Alex-Pennington/ArduinoHydraulicScale/README.md

Parts List and instructions can be found at
https://www.organicengineer.com/projects
