Alex-Pennington/ArduinoHydraulicScale/docs/superpowers/plans/2026-09-13-4-20ma-loop.md

# PLC #4 — 4-20 mA current loop implementation plan

> **For agentic workers:** REQUIRED SUB-SKILL: Use superpowers:subagent-driven-development (recommended) or superpowers:executing-plans to implement this plan task-by-task. Steps use checkbox (`- [ ]`) syntax for tracking.

**Goal:** Replace PLC #4's 0.5-4.5 V ratiometric pressure front end with a 4-20 mA current loop, and in doing so retire the two diagnostic defects the voltage front end cannot express.

**Verification available here:** `./tools/build-check.sh` compiles the firmware for `arduino:renesas_uno:unor4wifi` using Saga's `arduino-cli`, and `test/test_loop_scaling.cpp` runs the scaling arithmetic on the host with `g++`. Both were run on 2026-09-13 before this plan was handed over. **No board is tethered and nothing is flashed.**

**Architecture:** Milliamps become the source of truth. A new header `include/loop_scaling.h` holds the burden resistor, the NAMUR thresholds in mA, a `constexpr` that derives ADC counts from them, a five-state classifier, and the psi conversion — all free of Arduino dependencies so it can be compiled and checked on the host. `src/ArduinoHydraulicScale.cpp` includes it and loses its four hard-coded count constants and its three-state enum.

**Tech Stack:** C++17, Arduino framework, UNO R4 WiFi. Built with Saga's `arduino-cli` (`arduino:renesas_uno:unor4wifi`) via `tools/build-check.sh` — **not** PlatformIO, despite the tracked `platformio.ini`. Host checks build with `g++`.

**Spec:** `MA-LOOP-DESIGN.md`. Decisions, their owners and the hardware reasoning are in `notes/2026-09-13-4-20ma-loop-decisions.md`. **Read both — this plan argues from them and does not repeat their reasoning.**

---

## Global Constraints

- **Base branch is `plc4/mqtt-port`, not `main`.** HEAD is thirty commits ahead of `main`, which is stale upstream refactor history. Never diff against or merge from `main`.
- **Work on `feat/plc4-4-20ma-loop`.** Never push to `origin` — `CLAUDE.md` forbids it. Commit locally.
- **Never `git add -A` or `git commit -a`.** Stage by explicit path. Other sessions share this repo.
- **Alex is the tester.** Do not write, invent or critique a commissioning test, a bench procedure, or anything performed at the machine. The host checks in Task 1 prove arithmetic, not hardware.
- **Do not flash. Do not operate the tractor.** `tools/build-check.sh` compiles and never opens a port; keep it that way.
- **Toolchain is `arduino-cli` on Saga**, not PlatformIO. Do not install PlatformIO.
- **Burden resistor is 150 ohm.** `BURDEN_OHMS` is the only constant describing hardware; every threshold derives from it. Never hand-write a count.
- **`sensorMaxPSI` default is 3000** — a Rosemount 1151, 0-3000 psi.
- **NE43 fault-high is 21.0 mA, never 20.5.** `MA-LOOP-DESIGN.md` §2 carries the full argument; 20.5 would report a legitimately saturated transmitter as failed, which is the exact defect being fixed.
- **A0 is untouched.** The keypad ladder and the `analogReadResolution` flips — four calls, plus the one comment that names them — stay exactly as they are.
- **Describe problems, do not fix them, outside this feature.** Anything else you find goes in `findings/` or to the coordinator, not into a commit.
- **Verify every line number yourself before editing.** The numbers in this plan were verified on 2026-09-13 against `7e7f2f4`; earlier tasks in this plan will move them.

---

## The predicate split — read this before writing any code

This is the single most likely place to introduce a bug, because the old code had one predicate and the new code needs two.

The old enum had one "good" state, so `sensorState != SENSOR_OK` meant both *"don't trust this reading"* and *"don't let the operator act"*. The new enum splits those:

```cpp
loopState != LOOP_OK        // REFUSE AN OPERATOR ACTION  (tare, +, kv)
loopIsMeasuring(loopState)  // TRUST THE READING          (LCD, psi, filter)
```

They differ on exactly two states:

| state | `!= LOOP_OK` | `loopIsMeasuring()` | so… |
|---|---|---|---|
| `LOOP_UNDER` | refuses | **true** | reading is kept and published; operator cannot tare or calibrate on it |
| `LOOP_SATURATED` | refuses | **true** | weight stays on the LCD, psi is published, but no new tare or calibration |

**Do not "simplify" these back into one predicate.** Collapsing them toward `!= LOOP_OK` throws away the saturated readings this feature exists to capture. Collapsing them toward `loopIsMeasuring()` lets an operator calibrate against a pinned transmitter.

---

## File structure

| File | Status | Responsibility |
|---|---|---|
| `include/loop_scaling.h` | **create** | Burden, vref, mA thresholds, count derivation, `LoopState`, classifier, mA and psi conversion. No Arduino dependency. |
| `test/test_loop_scaling.cpp` | **create** | Host-side check of the above. Built with `g++` on the host, not cross-compiled. |
| `src/ArduinoHydraulicScale.cpp` | modify | Consumes the header; loses its four count constants and three-state enum. |
| `OPERATOR.md` | modify | New LCD strings; the forced recalibration after flashing. |
| `BRIEF.md` | modify | Hardware picture: transmitter, burden, loop supply. |
| `tools/build-check.sh` | **exists** | Assembles a scratch sketch and compiles it with `arduino-cli`. Never flashes. |

---

## Task 0: Confirm the compile check works — PREREQUISITE, and it is quick

**This repo CAN be compiled, and this plan's earlier draft was wrong to say otherwise.**
`CLAUDE.md` says nothing here has been compiled or flashed. That is stale: Saga carries
`arduino-cli` 1.5.0 with `arduino:renesas_uno` 1.6.0, and Alex confirms the estate has been
flashing with it. PlatformIO is **not** installed and is not needed — do not install it.

The repo is PlatformIO-layout (`src/*.cpp`) but `arduino-cli` wants a sketch *directory*
containing `<name>.ino`. `tools/build-check.sh` bridges that by assembling a throwaway sketch in
a scratch directory. **It never flashes and takes no port argument.** Flashing is Alex's, at the
machine.

**Files:** none modified.

- [ ] **Step 1: Compile the untouched baseline**

```bash
./tools/build-check.sh
```

Expected, verified on 2026-09-13 at `7e7f2f4`:

```
Sketch uses 85008 bytes (32%) of program storage space. Maximum is 262144 bytes.
Global variables use 11196 bytes (34%) of dynamic memory, leaving 21572 bytes for local variables.
```

**Write those two numbers down.** Every later task compares against them.

- [ ] **Step 2: Know which warning is not yours**

```
WARNING: library WDT claims to run on renesas architecture(s) and may be
incompatible with your current board which runs on renesas_uno architecture(s).
```

**Pre-existing.** It appears on the untouched baseline. Do not chase it and do not "fix" it — it
is outside this feature, and the standing constraint is to describe problems found outside the
feature, not fix them.

- [ ] **Step 3: If it fails, stop and report**

If `arduino-cli` is missing or the core is gone, **say so plainly and mark this task FAILED**.
Do not install a second toolchain, do not fall back to PlatformIO, and above all **never report a
build you did not run.** Every later task's verification step depends on this one working.

**Nothing to commit.**

---

## Task 1: `include/loop_scaling.h` and its host check

The only task in this plan with verification that does not depend on Task 0. It is also where the highest-risk content lives: `src/ArduinoHydraulicScale.cpp` already carries **three** documented instances of a hand-derived scaling constant left stale when the resolution changed (`:914-919` names all three). This header exists so there is no hand-derived constant to go stale, and this test exists to prove the derivation.

**Files:**
- Create: `include/loop_scaling.h`
- Create: `test/test_loop_scaling.cpp`

**Interfaces — later tasks rely on exactly these names:**

```cpp
enum LoopState { LOOP_OK, LOOP_DEAD, LOOP_UNDER, LOOP_SATURATED, LOOP_FAULT_HIGH };

constexpr int   mAToCounts(float mA);
constexpr int   COUNTS_DEAD, COUNTS_ZERO, COUNTS_FS, COUNTS_FAULT_HIGH;
LoopState       classifyLoop(int counts);
bool            loopIsMeasuring(LoopState s);
const char     *loopStateName(LoopState s);
float           countsToMilliamps(int counts);
int             countsToPSI(int counts, int maxPSI);
```

- [ ] **Step 1: Write the failing test**

Create `test/test_loop_scaling.cpp`:

```cpp
// Host-side check of the 4-20 mA scaling arithmetic in include/loop_scaling.h.
//
// Built with g++ ON THE HOST. The firmware itself cross-compiles fine via
// tools/build-check.sh, but a compile proves only that the arithmetic is legal,
// not that it is right. This file carries no Arduino dependency so the values
// can actually be RUN and inspected, which on a board nobody has tethered is
// otherwise impossible.
//
//   g++ -std=c++17 -Wall -Wextra -Iinclude test/test_loop_scaling.cpp -o /tmp/t
//   /tmp/t
//
// (No backslash continuation in that comment -- a trailing backslash on a //
// line trips -Wcomment, and this file must build warning-free.)
//
// THIS IS NOT A COMMISSIONING TEST. It proves arithmetic. It proves nothing
// about a transmitter, a burden resistor, or a tractor. Alex writes those.

#include "loop_scaling.h"
#include <cstdio>

static int failures = 0;

static void check_int(const char *what, long got, long want) {
  if (got == want) { printf("  ok    %-44s %ld\n", what, got); }
  else { printf("  FAIL  %-44s got %ld want %ld\n", what, got, want); failures++; }
}

static void check_near(const char *what, double got, double want, double tol) {
  double d = got - want; if (d < 0) d = -d;
  if (d <= tol) { printf("  ok    %-44s %.4f\n", what, got); }
  else { printf("  FAIL  %-44s got %.4f want %.4f\n", what, got, want); failures++; }
}

static void check_state(const char *what, LoopState got, LoopState want) {
  if (got == want) { printf("  ok    %-44s %s\n", what, loopStateName(got)); }
  else { printf("  FAIL  %-44s got %s want %s\n", what,
                loopStateName(got), loopStateName(want)); failures++; }
}

// The derived counts, against the values in MA-LOOP-DESIGN.md §2. If the burden
// is ever changed these must be recomputed there and here together.
static_assert(COUNTS_DEAD       == 1720,  "3.5 mA against 150 ohm");
static_assert(COUNTS_ZERO       == 1966,  "4.0 mA against 150 ohm");
static_assert(COUNTS_FS         == 9830,  "20.0 mA against 150 ohm");
static_assert(COUNTS_FAULT_HIGH == 10321, "21.0 mA against 150 ohm");

int main() {
  printf("counts derived from BURDEN_OHMS\n");
  check_int("3.5 mA  live-zero floor", COUNTS_DEAD,        1720);
  check_int("4.0 mA  live zero",       COUNTS_ZERO,        1966);
  check_int("20.0 mA full scale",      COUNTS_FS,          9830);
  check_int("21.0 mA NE43 fault-high", COUNTS_FAULT_HIGH, 10321);
  check_int("25.0 mA stays on scale",  mAToCounts(25.0f) <= 16383, 1);

  printf("\nclassifier boundaries -- every band edge, both sides\n");
  // AN OPEN LOOP READS ZERO, AND THAT IS THE WHOLE POINT OF THE SWAP.
  // The old front end's open-circuit defect was a floating CMOS input sitting
  // near mid-rail at ~4401 counts and reporting ok. There is deliberately NO
  // test for 4401 here: with a 150 ohm burden across the input a broken loop
  // CANNOT produce it -- 0 mA develops 0 V. The hardware closed that path, not
  // the classifier, and a test asserting otherwise would misrepresent the fix.
  check_state("0 counts -- open loop",        classifyLoop(0),     LOOP_DEAD);
  check_state("1719 -- just under 3.5 mA",    classifyLoop(1719),  LOOP_DEAD);
  check_state("1720 -- exactly 3.5 mA",       classifyLoop(1720),  LOOP_UNDER);
  check_state("1965 -- just under live zero", classifyLoop(1965),  LOOP_UNDER);
  check_state("1966 -- exactly live zero",    classifyLoop(1966),  LOOP_OK);
  check_state("9829 -- just under full scale",classifyLoop(9829),  LOOP_OK);
  check_state("9830 -- exactly full scale",   classifyLoop(9830),  LOOP_SATURATED);
  check_state("10320 -- just under NE43",     classifyLoop(10320), LOOP_SATURATED);
  check_state("10321 -- exactly NE43 21 mA",  classifyLoop(10321), LOOP_FAULT_HIGH);
  check_state("16383 -- ADC rail",            classifyLoop(16383), LOOP_FAULT_HIGH);

  printf("\nwhich states are still measuring\n");
  // SATURATED IS MEASURING. NE43 puts 20.0-20.5 mA in the valid measuring range
  // and this is the defect the swap exists to fix: today a real pressure
  // excursion publishes as a wiring fault. If this line ever flips to false,
  // the fix has been undone.
  check_int("LOOP_OK measures",         loopIsMeasuring(LOOP_OK),         1);
  check_int("LOOP_UNDER measures",      loopIsMeasuring(LOOP_UNDER),      1);
  check_int("LOOP_SATURATED MEASURES",  loopIsMeasuring(LOOP_SATURATED),  1);
  check_int("LOOP_DEAD does not",       loopIsMeasuring(LOOP_DEAD),       0);
  check_int("LOOP_FAULT_HIGH does not", loopIsMeasuring(LOOP_FAULT_HIGH), 0);

  printf("\ncounts back to milliamps\n");
  check_near("live zero is 4 mA",  countsToMilliamps(COUNTS_ZERO),  4.0,  0.01);
  check_near("full scale is 20 mA",countsToMilliamps(COUNTS_FS),   20.0,  0.01);
  check_near("zero counts is 0 mA",countsToMilliamps(0),            0.0,  0.01);

  printf("\ncounts to psi, span 3000\n");
  check_int("live zero is 0 psi",      countsToPSI(COUNTS_ZERO, 3000),    0);
  check_int("full scale is 3000 psi",  countsToPSI(COUNTS_FS,   3000), 3000);
  check_int("midspan is 1500 psi",     countsToPSI(5898,        3000), 1500);
  // The floor. map() does not clamp, and LOOP_UNDER sits below the live zero,
  // so without this a healthy-looking negative pressure reaches the wire.
  check_int("below live zero floors at 0", countsToPSI(COUNTS_DEAD, 3000), 0);
  check_int("zero counts floors at 0",     countsToPSI(0,           3000), 0);
  // Above full scale it EXTRAPOLATES, deliberately: a saturating transmitter is
  // proportional up to its clamp. Per playbook §10 this is a validity boundary,
  // not a scale marking -- read it as "at least this much".
  check_int("saturated extrapolates",  countsToPSI(10000, 3000), 3064);

  printf("\n%s\n", failures ? "FAILURES" : "all checks passed");
  return failures ? 1 : 0;
}
```

- [ ] **Step 2: Run it and confirm it fails**

```bash
g++ -std=c++17 -Wall -Wextra -Iinclude -o /tmp/test_loop_scaling \
    test/test_loop_scaling.cpp && /tmp/test_loop_scaling
```

Expected: FAIL — `fatal error: loop_scaling.h: No such file or directory`.

- [ ] **Step 3: Write the header**

Create `include/loop_scaling.h`:

```cpp
#pragma once

// ---------------------------------------------------------------------------
// PLC #4 — 4-20 mA current loop front end.
//
// The transmitter is a Rosemount 1151, 0-3000 psi, 2-wire, fed from a DEDICATED
// 24 V supply whose negative is bonded to this board's GND. Loop current is read
// as the voltage across a burden resistor from A2 to GND.
//
// BURDEN_OHMS IS THE ONLY NUMBER HERE THAT DESCRIBES HARDWARE. Change it and
// every threshold below follows. NEVER HAND-WRITE A COUNT: this firmware already
// carries three cases of a hand-derived scaling constant left stale when the
// resolution changed, and a count that silently *means* 21.0 mA would be a
// fourth.
//
// WHY 150 OHM, so nobody re-argues it on resolution grounds: resolution binds on
// nothing -- every candidate from 100 to 250 ohm is 52-131x finer than the
// sensor's own +/-1.0% FS -- and compliance binds on nothing at 24 V. What binds
// is that PLC #3 metered a 29.7 mA hard-over; against 200 ohm that puts 5.94 V
// on this pin, 0.94 V above AVCC and into the ESD clamp. 150 ohm holds to
// 33.3 mA. Full trade table: notes/2026-09-13-4-20ma-loop-decisions.md §2.
//
// BURDEN TOLERANCE IS NOW A CALIBRATION TERM AND IT WAS NOT BEFORE. A 1% burden
// is +/-30 psi at 3000 -- the entire sensor accuracy budget. Specify 0.1%,
// <=25 ppm/degC; at 100 ppm/degC a 60 degC enclosure swing adds another 18 psi.
//
// AND SO IS AVCC. The old transducer was RATIOMETRIC: its output tracked AVCC,
// so AVCC error cancelled. A burden does not cancel -- the reading is I*R/AVCC,
// so ADC_VREF_V below is a direct gain term. 5.0 is an ASSUMPTION about a rail
// that on USB power is typically 4.75-5.25 V. UNRESOLVED; may want measuring.
//
// Deliberately free of Arduino headers so test/test_loop_scaling.cpp can check
// the arithmetic on the host, where nothing else in this firmware can be run.
// ---------------------------------------------------------------------------

constexpr float BURDEN_OHMS = 150.0f;   // 0.1%, <=25 ppm/degC, A2 to GND
constexpr float ADC_VREF_V  = 5.0f;     // see the AVCC warning above
constexpr int   ADC_FS      = 16383;    // 14-bit full scale is 16383, not 16384

constexpr int mAToCounts(float mA) {
  return (int)(mA * BURDEN_OHMS / ADC_VREF_V / 1000.0f * (float)ADC_FS + 0.5f);
}

// NAMUR NE43 and the estate's settled figures. Every value cites a source; none
// is invented here.
//
// WHY 21.0 AND NOT 20.5, because it will be questioned. NE43 puts the valid
// measuring range at 3.8-20.5 mA and the fault signal at >=21.0; 20.5-21.0 is
// over-range-but-still-measuring and is deliberately NOT a fault. 21.0 also sits
// in the gap for both Rosemount alarm configurations (standard saturates 20.8 /
// alarms >=21.75; NE43 option saturates 20.5 / alarms >=21.5), so it
// discriminates correctly without anyone knowing the option code.
//
// A 20.5 THRESHOLD WOULD BE WRONG RATHER THAN CONSERVATIVE: it would report a
// transmitter legitimately pinned at full scale, measuring correctly and saying
// so, as FAILED -- which is precisely the defect this front end exists to fix.
constexpr float LOOP_DEAD_MA       =  3.5f;  // playbook §5; PLC #1 CURRENT_DEAD_LOOP_MA
constexpr float LOOP_ZERO_MA       =  4.0f;  // live zero
constexpr float LOOP_FS_MA         = 20.0f;  // span end
constexpr float LOOP_FAULT_HIGH_MA = 21.0f;  // NAMUR NE43

constexpr int COUNTS_DEAD       = mAToCounts(LOOP_DEAD_MA);        // 1720
constexpr int COUNTS_ZERO       = mAToCounts(LOOP_ZERO_MA);        // 1966
constexpr int COUNTS_FS         = mAToCounts(LOOP_FS_MA);          // 9830
constexpr int COUNTS_FAULT_HIGH = mAToCounts(LOOP_FAULT_HIGH_MA);  // 10321

enum LoopState { LOOP_OK, LOOP_DEAD, LOOP_UNDER, LOOP_SATURATED, LOOP_FAULT_HIGH };

inline LoopState classifyLoop(int counts) {
  if (counts <  COUNTS_DEAD)       return LOOP_DEAD;
  if (counts <  COUNTS_ZERO)       return LOOP_UNDER;
  if (counts >= COUNTS_FAULT_HIGH) return LOOP_FAULT_HIGH;
  if (counts >= COUNTS_FS)         return LOOP_SATURATED;
  return LOOP_OK;
}

// WHETHER TO TRUST THE READING. Distinct from `state != LOOP_OK`, which is
// whether to let the OPERATOR ACT. They differ on LOOP_UNDER and LOOP_SATURATED:
// both still carry a real measurement, and neither is a safe basis for a new
// tare or calibration. Do not collapse the two predicates into one.
inline bool loopIsMeasuring(LoopState s) {
  return s == LOOP_OK || s == LOOP_UNDER || s == LOOP_SATURATED;
}

// Operator-facing, and on the MQTT wire. All fit the 16-column LCD.
// `ok` and `NO SENSOR` keep their exact old spellings so the two values
// downstream already branches on do not move. `SENSOR SHORT` is gone: a
// current loop is current-limited and has no rail to short to.
inline const char *loopStateName(LoopState s) {
  switch (s) {
    case LOOP_DEAD:       return "NO SENSOR";
    case LOOP_UNDER:      return "UNDER ZERO";
    case LOOP_SATURATED:  return "SATURATED";
    case LOOP_FAULT_HIGH: return "XMTR FAULT";
    default:              return "ok";
  }
}

// The unit a person with a meter at the machine is comparing against.
inline float countsToMilliamps(int counts) {
  return (float)counts * ADC_VREF_V / (float)ADC_FS / BURDEN_OHMS * 1000.0f;
}

// Long arithmetic: (16383-1966)*3000 is 43 million and overflows a 16-bit int.
// FLOORED AT 0 (playbook §4) because LOOP_UNDER sits below the live zero and an
// unclamped conversion would put a negative pressure on the wire.
// Above COUNTS_FS it EXTRAPOLATES deliberately -- a saturating transmitter is
// proportional up to its clamp -- but per playbook §10 a reading past the
// transmitter's rated maximum is a VALIDITY BOUNDARY, NOT A SCALE MARKING.
// Read anything above maxPSI as "at least this much".
inline int countsToPSI(int counts, int maxPSI) {
  long num = (long)(counts - COUNTS_ZERO) * (long)maxPSI;
  long psi = num / (long)(COUNTS_FS - COUNTS_ZERO);
  return psi < 0 ? 0 : (int)psi;
}
```

- [ ] **Step 4: Run the test and confirm it passes**

**These 35 checks were compiled and run on the host with g++ 13.3.0 on 2026-09-13, before this plan was handed over, and all passed.** If any of them fails for you, the header you wrote differs from the one above — diff it before changing an expected value.

```bash
g++ -std=c++17 -Wall -Wextra -Iinclude -o /tmp/test_loop_scaling \
    test/test_loop_scaling.cpp && /tmp/test_loop_scaling
```

Expected: every line `ok`, final line `all checks passed`, exit 0. **No warnings.**

If a `static_assert` fires, the derivation disagrees with `MA-LOOP-DESIGN.md` §2. Do not adjust the expected value to match the code — work out which is wrong first, and if the design is wrong, fix the design document and say so.

- [ ] **Step 5: Commit**

```bash
git add include/loop_scaling.h test/test_loop_scaling.cpp
git commit -m "PLC #4: derive the 4-20 mA thresholds instead of hand-writing them

Milliamps are the source of truth; counts come from a constexpr against
BURDEN_OHMS, so changing the burden moves every threshold and nothing is
hand-derived. This file has three documented cases of exactly that going stale
when the resolution changed (:914-919 names all of them).

Host-checkable with g++ because nothing else here can be run: no toolchain for
the target is installed and no board is tethered. It proves arithmetic and
claims nothing about hardware.

Five states replace three. SATURATED is a measuring state, which is the whole
point: 20.0-21.0 mA is over-range-but-still-measuring under NE43, and today a
real pressure excursion publishes as a wiring fault instead.

No behaviour change yet -- the header is not wired in."
```

---

## Task 2: Wire the header in; replace the constants, the enum and the classifier

**Files:**
- Modify: `src/ArduinoHydraulicScale.cpp` — the include block (`:9-17`), the scaling block (`:64-81`), `sensorStateName()` (`:352-357`), the classifier (`:896-903`)

**Interfaces — consumes:** everything from Task 1.
**Produces:** the global `LoopState loopState` that Tasks 3-7 read.

- [ ] **Step 1: Add the include**

After `#include "arduino_secrets.h"` (`:17`):

```cpp
#include "loop_scaling.h"
```

- [ ] **Step 2: Delete the old scaling block and enum**

Remove `:64` through `:81` — the whole `Transducer scaling` comment banner, the four `SENSOR_COUNTS_*` constants, the `T4` comment and `enum SensorState` with its `sensorState` variable. Replace with:

```cpp
// ---------------------------------------------------------------------------
// Transducer scaling lives in include/loop_scaling.h, in MILLIAMPS, with the
// ADC counts derived from BURDEN_OHMS at compile time. Nothing here hard-codes
// a count. See MA-LOOP-DESIGN.md for the design and
// notes/2026-09-13-4-20ma-loop-decisions.md for why the burden is 150 ohm.
// ---------------------------------------------------------------------------
LoopState loopState = LOOP_OK;
```

**Leave `:62` (`const int analogInPin = A2;`) and its history comment at `:55-61` exactly as they are.** The burden goes across A2 to GND; the pin does not move, and that comment records a real and expensive confusion.

- [ ] **Step 3: Replace `sensorStateName()`**

`:352-357` becomes a one-line forward to the header, so the LCD and the wire can never disagree about what a state is called:

```cpp
static const char *sensorStateName() { return loopStateName(loopState); }
```

Keep the name `sensorStateName` — it has six call sites and renaming them is churn that buys nothing.

- [ ] **Step 4: Replace the classifier**

`:896-903` — the `T4: classify before converting` comment, the over-range counting and the three-way `if` — becomes:

```cpp
    // Classify before converting. The burden resistor makes an open loop read
    // ~0 counts rather than floating mid-rail, so LOOP_DEAD is now a real
    // measurement of loop integrity rather than a hopeful threshold.
    loopState = classifyLoop(sensorValue);

    // SATURATED is the 20.0-21.0 mA NE43 band: at or past full scale and STILL
    // MEASURING. It is counted, not faulted. Counting it is how the question of
    // how far past 3000 psi this circuit actually goes gets answered.
    if (loopState == LOOP_SATURATED) {
      overRangeCount++;
      if (sensorValue > overRangeMaxCounts) overRangeMaxCounts = sensorValue;
    }
    if (loopState == LOOP_UNDER) underRangeCount++;
```

- [ ] **Step 5: Declare the new counter**

Beside `overRangeMaxCounts` (`:260`):

```cpp
// The 3.5-4.0 mA dead band: below the live zero but above a dead loop. Reads as
// a healthy 0 psi and is STRUCTURALLY UNCHANGED by the swap (playbook §8). What
// the swap does remove is its dominant cause, excitation sensitivity -- a
// current loop has no excitation dependency, so a sagging supply can no longer
// move the reading. What can still land here is a transmitter drifting below
// its own zero, which is a calibration problem rather than a wiring one.
// Counting it is the mitigation, not a fix.
unsigned long underRangeCount = 0;
```

- [ ] **Step 6: Fix every remaining reference to the old enum**

```bash
grep -n 'SENSOR_OK\|SENSOR_OPEN\|SENSOR_SHORT\|sensorState\b\|SENSOR_COUNTS' src/ArduinoHydraulicScale.cpp
```

Expected remaining sites, all of which are **operator-action guards** and all of which become `loopState != LOOP_OK` — see *The predicate split* above:

| line | site | why it stays strict |
|---|---|---|
| `:423` | `queueBuf[tail].sensorAtCapture = (uint8_t)sensorState;` | becomes `(uint8_t)loopState`; five values now, same mechanism |
| `:617` | EEPROM tare bounds | **Task 4 handles this — leave it for now** |
| `:967` | `tare` | a tare is taken empty at the boom mark; below the live zero or pinned at full scale is not a valid zero |
| `:983` | `+` record a weight | a pinned reading understates the load. A recorded weight is a deliberate act with lasting value (`:266-270`) and deserves a refusal, not a floor |
| `:1064` | `kv` calibrate | calibrating against a pinned transmitter bakes the error into EEPROM |

`:775` (the LCD) is **Task 6** and does **not** become `!= LOOP_OK`. Leave it.

- [ ] **Step 7: Verify**

```bash
g++ -std=c++17 -Wall -Wextra -Iinclude -o /tmp/test_loop_scaling \
    test/test_loop_scaling.cpp && /tmp/test_loop_scaling
grep -c 'SENSOR_OK\|SENSOR_OPEN\|SENSOR_SHORT\|SENSOR_COUNTS' src/ArduinoHydraulicScale.cpp
```

Expected: test still passes; grep count is **0**.

```bash
./tools/build-check.sh
```

Expected: a clean compile. Flash grows by a few hundred bytes at most; **RAM should move by no
more than a handful of bytes** — one extra `unsigned long` counter and an enum. If RAM jumps by
hundreds, something is wrong: check you have not left both the old and new constant blocks in
place.

- [ ] **Step 8: Commit**

```bash
git add src/ArduinoHydraulicScale.cpp
git commit -m "PLC #4: five loop states replace three, and SENSOR_SHORT retires

A current loop is current-limited and has no rail to short to, so SENSOR_SHORT
described a condition that can no longer occur -- while the thing it was firing
on, a real pressure excursion past span, had no state of its own. That is the
defect: :897 counted over-range only in a narrow band below the short threshold,
so genuine excursions published as a wiring fault AND went uncounted.

SATURATED now carries them and increments overrange, so overrange_max finally
measures how far past 3000 psi this circuit goes.

The operator-action guards (tare, +, kv) stay strict on LOOP_OK: a pinned or
below-zero reading is not a valid basis for a zero or a span. That is a DIFFERENT
predicate from whether the reading is trustworthy, which is loopIsMeasuring().
Do not collapse them."
```

---

## Task 3: Pressure conversion

**Files:** Modify `src/ArduinoHydraulicScale.cpp` — the psi comment and conversion (`:909-931`)

- [ ] **Step 1: Replace the conversion**

The `map()` call at `:930-931` becomes:

```cpp
    pressureValue = countsToPSI((int)smoothedValue, sensorMaxPSI);
```

- [ ] **Step 2: Rewrite the `sm` comment**

The block at `:914-928` describes the voltage front end and is now wrong. Replace with:

```cpp
    // The psi conversion starts at the LIVE ZERO (4 mA), not at zero counts.
    // Mapping from 0 counts reported 299 psi at true 0 psi and 2699 at true
    // 3000 -- an offset AND a compressed span. DO NOT UNDO THAT.
    //
    // This value is PUBLISHED as `psi`, so it is not display-only cosmetics.
    //
    // What `sm` can rescale, and it is CLEANER than the voltage front end it
    // replaces: a different PRESSURE range with the same 4-20 mA output needs
    // `sm` ALONE. The count endpoints come from the burden resistor and do not
    // move when the psi span does. Under the old 0.5-4.5 V part a different
    // OUTPUT range would have moved both endpoints too.
    //
    // The live hazard is unchanged and it is not the arithmetic: `sm` is NOT
    // PERSISTED and reverts to the compile-time default on every reset. A
    // non-default range wants the default below changed, not `sm` typed after
    // each boot.
```

- [ ] **Step 3: Confirm `sensorMaxPSI` is 3000**

`:97` should already read `int sensorMaxPSI = 3000;`. Update its trailing comment:

```cpp
int sensorMaxPSI = 3000; // Rosemount 1151 span, 0-3000 psi. See MA-LOOP-DESIGN.md §5.
```

- [ ] **Step 4: Verify**

```bash
grep -n 'map((int)smoothedValue\|countsToPSI' src/ArduinoHydraulicScale.cpp
```

Expected: the `map(` line is gone, `countsToPSI` is present once.

```bash
./tools/build-check.sh
```

Expected: a clean compile.

- [ ] **Step 5: Commit**

```bash
git add src/ArduinoHydraulicScale.cpp
git commit -m "PLC #4: psi from the live zero, floored, via the shared conversion

map() does not clamp, and LOOP_UNDER sits below the 4 mA live zero, so an
unclamped conversion would put a negative pressure on the wire. countsToPSI
floors at 0 (playbook s4) and is the same function the host test exercises.

Above full scale it extrapolates deliberately -- a saturating transmitter is
proportional up to its clamp -- but per playbook s10 that is a validity
boundary, not a scale marking: read anything above sm as 'at least this much'.

Rewrites the sm comment, which described the voltage front end. Under a current
loop a different psi range with the same 4-20 mA output needs sm alone, because
the count endpoints come from the burden and do not move. The hazard that sm is
not persisted is unchanged."
```

---

## Task 4: Weight path — filter freeze and the EEPROM signature

Both changes were **approved by Alex specifically**, on 2026-09-13, because they reach outside the sensor block into how the machine weighs. `CLAUDE.md` requires that approval and it has been given. Do not extend it to anything else in the weight path.

**Files:** Modify `src/ArduinoHydraulicScale.cpp` — `EEPROM_SIGNATURE` (`:176`), tare bounds (`:617`), the filter (`:907`)

- [ ] **Step 1: Freeze the filter on a non-measuring state**

`:907` currently runs unconditionally:

```cpp
    smoothedValue = (smoothedValue * alpha) + (sensorValue * (1 - alpha));
```

becomes:

```cpp
    // A faulted read must not touch the filter. Fed unconditionally, a dead
    // loop drags the weight SMOOTHLY DOWN to a plausible-looking number -- it
    // looks like a load being set down, which is this machine's characteristic
    // failure: a plausible wrong answer rather than a visible one. Holding the
    // last reading is playbook §6's rule and what PLC #3 does. The LCD writes
    // the fault over the weight either way, so a held value is never shown as
    // current.
    if (loopIsMeasuring(loopState)) {
      smoothedValue = (smoothedValue * alpha) + (sensorValue * (1 - alpha));
    }
```

**`loopIsMeasuring()`, not `loopState != LOOP_OK`.** A saturated reading is real and must keep feeding the filter.

- [ ] **Step 2: Bump the EEPROM signature**

`:176`:

```cpp
const uint32_t EEPROM_SIGNATURE = 0x504C3441;   // 'PL4A'  4-20 mA calibration block
```

Add above it:

```cpp
// BUMPED 2026-09-13 for the 4-20 mA front end, with Alex's specific approval.
// Counts-per-psi moved by ~1.67x (13107 counts of span became 7864), so a
// voltage-era tareValue and calFactor would restore CLEANLY, pass the bounds
// check below, and publish "cal":"ok" over a scale wrong by that ratio. That is
// the same failure as the 16256 leftover documented at the EEPROM restore --
// which this signature was added to catch, and which the OLD value would miss.
//
// CONSEQUENCE, ACCEPTED: the board demands a full recalibration after flashing
// and will not weigh correctly until it gets one.
```

- [ ] **Step 3: Move the tare bounds**

`:617`:

```cpp
  if (tareValue < COUNTS_DEAD || tareValue > COUNTS_FS) { tareValue = COUNTS_ZERO; defaulted = true; }
```

`COUNTS_DEAD` rather than `COUNTS_ZERO` as the lower bound, so a tare taken slightly below the live zero is not rejected as impossible.

- [ ] **Step 4: Verify**

```bash
grep -n 'EEPROM_SIGNATURE = \|loopIsMeasuring(loopState)\|tareValue < COUNTS' src/ArduinoHydraulicScale.cpp
```

Expected: signature is `0x504C3441`; `loopIsMeasuring` guards the filter; bounds use `COUNTS_DEAD` / `COUNTS_FS`.

```bash
./tools/build-check.sh
```

Expected: a clean compile.

- [ ] **Step 5: Commit**

```bash
git add src/ArduinoHydraulicScale.cpp
git commit -m "PLC #4: hold the last reading on fault, and refuse a stale calibration

Both approved by Alex 2026-09-13 as specific changes to the weight path.

The filter was fed unconditionally, so a dead loop decayed the weight smoothly
to a plausible number rather than stopping -- it reads as a load being set down.
Guarded by loopIsMeasuring(), NOT by != LOOP_OK: a saturated reading is real and
must keep feeding the filter.

EEPROM_SIGNATURE goes to PL4A because counts-per-psi moved 1.67x, so a
voltage-era tare and factor would restore clean, pass the bounds check and
publish cal:ok over a scale wrong by that ratio -- the failure the signature
exists to catch and the old value would miss. The board now demands a full
recalibration after flashing. That is the intended cost."
```

---

## Task 5: MQTT contract

Filed upstream as `Alex-Pennington/greybeard-plc-consumer#5`. The consumer's rule is `if sensor != PLC4_SENSOR_OK:` → nulls the values, which would **discard every saturated reading**. That is their change to make, not this repo's.

**Files:** Modify `src/ArduinoHydraulicScale.cpp` — telemetry (`:948-953`), status (`:390-401`)

- [ ] **Step 1: Grow the telemetry buffer and add the fields**

`:948`: `char payload[128];` becomes `char payload[192];`

**This is not cosmetic.** Worst case today is ~101 bytes; `psi_fault` and `mA` push past 128 and `snprintf` truncates **silently into invalid JSON**.

`:949-953` becomes:

```cpp
    // psi publishes JSON null, NEVER 0, when the loop is not measuring. A real
    // zero and a dead transmitter are different things and must be reported
    // differently at every layer (playbook §6). psi_fault carries the DIRECTION
    // because fail-low is a wiring question and fail-high is not -- they lead to
    // different first checks at the machine. Both field names match PLC #3.
    // mA is the unit a person with a meter at the machine is comparing against.
    char psiField[12];
    if (loopIsMeasuring(loopState)) snprintf(psiField, sizeof(psiField), "%d", pressureValue);
    else                            snprintf(psiField, sizeof(psiField), "null");

    const char *psiFault = "null";
    if (loopState == LOOP_DEAD)            psiFault = "\"low\"";
    else if (loopState == LOOP_FAULT_HIGH) psiFault = "\"high\"";

    snprintf(payload, sizeof(payload),
             "{\"w\":%d,\"psi\":%s,\"mA\":%.2f,\"counts\":%d,\"sensor\":\"%s\","
             "\"psi_fault\":%s,\"queued\":%d,\"id\":\"%s\"}",
             outputValue, psiField, (double)countsToMilliamps(sensorValue),
             sensorValue, sensorStateName(), psiFault, queueCount, CLIENT_ID);
```

- [ ] **Step 2: Grow the status buffer and add the counter**

`:390`: `char payload[320];` becomes `char payload[384];`

In the format string at `:392-395`, after `"overrange":%lu,"overrange_max":%d,` add `"underrange":%lu,`, and add `underRangeCount` to the argument list immediately after `overRangeMaxCounts` — **in the same position**, or every field after it prints the wrong value.

- [ ] **Step 3: Leave the other two payloads alone**

`publishWeight()` (`:364`) and `queueFlush()` (`:432`) keep `char payload[128]`. They carry `sensorStateName()` but none of the new fields, and the longest new string (`UNDER ZERO`, `SATURATED`, `XMTR FAULT`) is **shorter** than the `SENSOR SHORT` it replaces.

- [ ] **Step 4: Verify the format string by hand**

Count the `%` conversions in each `snprintf` and match them one-for-one against the argument list, left to right. A mismatch here is undefined behaviour on the target and the host test cannot catch it.

```bash
grep -n 'char payload\[' src/ArduinoHydraulicScale.cpp
```

Expected: `128` at the two weight sites, `384` at status, `192` at telemetry.

```bash
./tools/build-check.sh
```

Expected: a clean compile **with no `-Wformat` warning**. That warning is the one thing here the
host test cannot catch, and it is the failure mode a hand-edited `snprintf` argument list
actually has — take it seriously if it appears.

- [ ] **Step 5: Commit**

```bash
git add src/ArduinoHydraulicScale.cpp
git commit -m "PLC #4: psi publishes null, not zero, and the loop current goes on the wire

Null is not zero at every layer (playbook s6): a real zero and a dead
transmitter are different things. psi_fault carries the direction because
fail-low is a wiring question and fail-high is not, and they lead to different
first checks at the machine. Both field names match PLC #3 so the estate reads
the same way. mA is what a person with a meter is comparing against.

payload[128] at the telemetry site grows to 192. Worst case today is ~101 bytes
and the new fields push past 128, where snprintf truncates SILENTLY into invalid
JSON. The two weight payloads stay at 128 -- they gain no fields, and the
longest new state string is shorter than the SENSOR SHORT it replaces.

Consumers switching on sensor need updating; filed as
Alex-Pennington/greybeard-plc-consumer#5."
```

---

## Task 6: LCD

**Files:** Modify `src/ArduinoHydraulicScale.cpp` — `hmiDrawHome()` (`:772-790`)

- [ ] **Step 1: Replace the row-0 rule**

`:775` currently reads `if (sensorState != SENSOR_OK)`, which would now **hide the weight during saturation** — the exact behaviour this feature is fixing. It becomes:

```cpp
  // Row 0: the weight, or the fault that makes the weight meaningless.
  //
  // SATURATED AND UNDER ZERO DO NOT TAKE THIS ROW. They are real measurements
  // -- over-range or below the live zero, but measuring -- and withholding a
  // weight from the operator because the transmitter is pinned is the defect
  // this front end replaced, not a safeguard. They are visible in telemetry and
  // in the overrange/underrange counters.
  if (!loopIsMeasuring(loopState)) snprintf(l0, sizeof(l0), "%-16s", sensorStateName());
  else                             snprintf(l0, sizeof(l0), "%-11d n%-3d", outputValue, rTindex);
```

- [ ] **Step 2: Confirm every string fits 16 columns**

`NO SENSOR` 9, `UNDER ZERO` 10, `SATURATED` 9, `XMTR FAULT` 10, `ok` 2. All fit `%-16s` into `char l0[17]`.

- [ ] **Step 3: Verify**

```bash
grep -n 'loopIsMeasuring\|sensorStateName()' src/ArduinoHydraulicScale.cpp | sed -n '1,20p'
```

Expected: `hmiDrawHome` uses `!loopIsMeasuring(loopState)`; the three operator-action guards still use `!= LOOP_OK`.

```bash
./tools/build-check.sh
```

Expected: a clean compile.

- [ ] **Step 4: Commit**

```bash
git add src/ArduinoHydraulicScale.cpp
git commit -m "PLC #4: a pinned transmitter no longer blanks the operator's weight

hmiDrawHome hid the weight whenever the state was not ok. Under five states that
would blank the display every time the circuit went over range -- which the owner
reports is routine -- and withholding a weight because the transmitter is pinned
is the defect this front end replaced, not a safeguard.

Row 0 now keys on loopIsMeasuring(), so only NO SENSOR and XMTR FAULT take it.
SATURATED and UNDER ZERO stay visible in telemetry and in the counters."
```

---

## Task 7: Console

**Files:** Modify `src/ArduinoHydraulicScale.cpp` — `printDebug()` (around `:1196-1217`)

- [ ] **Step 1: Add the loop current to the debug line**

After the `v = ` lines (around `:1199-1200`), add:

```cpp
    Console.print("mA = ");
    Console.println(countsToMilliamps(sensorValue), 2);
```

Keep `v = ` — it is the millivolt figure a meter across the burden resistor reads, and it is the direct check that the burden is the value it is supposed to be.

- [ ] **Step 2: Verify**

```bash
grep -n 'mA = ' src/ArduinoHydraulicScale.cpp
```

Expected: one hit, inside `printDebug()`.

`:1158` and `:1214` already print `sensorStateName()` and need no edit — they follow the retargeted function from Task 2.

```bash
./tools/build-check.sh
```

Expected: a clean compile.

- [ ] **Step 3: Commit**

```bash
git add src/ArduinoHydraulicScale.cpp
git commit -m "PLC #4: print the loop current beside the millivolts

mA is the unit a person at the machine is comparing against a meter. mV stays
because it is the direct check that the burden resistor is the value it is
supposed to be -- which is now a calibration term and was not before."
```

---

## Task 8: Operator and brief documentation

**Files:** Modify `OPERATOR.md`, `BRIEF.md`

- [ ] **Step 1: Read both files before editing**

```bash
grep -n -i 'sensor\|NO SENSOR\|SHORT\|transducer\|psi\|cal' OPERATOR.md | head -40
grep -n -i 'transducer\|0.5-4.5\|3000\|sensor' BRIEF.md | head -40
```

Follow the existing voice and structure. Do not restructure either document.

- [ ] **Step 2: Update `OPERATOR.md`**

Three operator-visible changes:

1. **The LCD vocabulary.** `SENSOR SHORT` is gone. `XMTR FAULT` (transmitter faulted or loop over 21 mA) and `NO SENSOR` (dead loop) blank the weight. `SATURATED` and `UNDER ZERO` do **not** appear on the LCD — describe them as telemetry-only so nobody waits for a display that never comes.
2. **After flashing, the scale demands a full recalibration** — `CAL NOT SET!` on row 1 — and will not weigh correctly until it is tared and calibrated. This is deliberate: the stored calibration belongs to the old front end and is wrong by about 1.67x.
3. **`tare`, `+` and `kv` refuse unless the loop reads `ok`** — including when it is saturated. The refusal names the state.

**Do not write a commissioning or bench procedure.** Describe what the operator will see, not what to do at the machine to prove it. Alex writes those.

- [ ] **Step 3: Update `BRIEF.md`'s hardware picture**

Transmitter: Rosemount 1151, 0-3000 psi, 2-wire 4-20 mA. Burden: 150 ohm, 0.1%, <=25 ppm/degC, A2 to GND. Loop supply: dedicated 24 V, negative bonded to board GND. Point at `MA-LOOP-DESIGN.md` and `notes/2026-09-13-4-20ma-loop-decisions.md` rather than restating their reasoning.

- [ ] **Step 4: Commit**

```bash
git add OPERATOR.md BRIEF.md
git commit -m "PLC #4: document the loop front end for the operator and the brief

SENSOR SHORT is gone from the LCD; XMTR FAULT and NO SENSOR replace it as the
two states that blank the weight. SATURATED and UNDER ZERO are telemetry-only
and deliberately never reach the display, so the operator is told that rather
than left waiting for one.

Records that the board demands a full recalibration after flashing, and why:
the stored calibration belongs to the old front end and is wrong by ~1.67x."
```

---

## Final report

State plainly, in this order:

1. **Whether it compiles**, with the flash and RAM figures from the last `./tools/build-check.sh`, against the 85008 / 11196 baseline. **Never report a build you did not run.**
2. The host test output from Task 1, verbatim.
3. The commits made, with SHAs.
4. Anything found and deliberately not fixed, per the standing constraint — into `findings/` or to the coordinator, not into a commit.

**Not flashed. Not bench-tested. Every claim about runtime behaviour in this plan is read from source and should be reported as such.**
