Alex-Pennington/ArduinoHydraulicScale/(commit log)

2025-04-25 Refactor smoothing algorithm and adjust calibration calculations for improved accuracy
2025-04-25 Refactor debug output handling and improve readability of printDebug function
2026-09-01 PLC #4: forward-port the MQTT layer onto main, with the work order ahead of it
    Port gate opened by Alex. Branched from origin/main; not flashed, no board
    tethered.
    Work order, in sequence:
    F1 - watchdog armed in setup() before any networking exists, so a hang in
    the reconnect path has a floor under it. That was the whole reason it was
    sequenced first.
    T4 - live-zero fault detection. Counts below 1311 (0.4 V) read as
    NO SENSOR, above 15400 (4.7 V) as SENSOR SHORT, against the transducer's
    1638-count live zero. Pattern ported from PLC #1's CURRENT_DEAD_LOOP_MA;
    the constant is ours. A faulted sensor now refuses to record, tare or
    calibrate rather than producing a plausible number - a chafed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
2026-09-01 PLC #4: record the new repository, and why main was not seeded here
    origin now points at Alex-Pennington/greybeard-plc4-tractor-scale and
    upstream at the public ArduinoHydraulicScale. Both work branches pushed.
    main on the new repo is deliberately not seeded: this session's standing
    constraints forbid pushing to main or master on any repository, with no
    exception for an empty branch or for who relays the request. That is a
    constraint on the session, not a judgement - seeding from upstream/main is
    very likely right. Left the one command for Alex or the coordinator to run,
    recorded as open question 11.
2026-09-01 PLC #4: fix the watchdog/WiFi timeout conflict, and verify the build
    The build is verified. arduino-cli compile against renesas_uno 1.6.0
    succeeds: 79,940 bytes flash (30%), 10,256 bytes RAM (31%), 22,512 left
    for locals. The 1.6 KB queue costs what the plan predicted. PlatformIO is
    not installed here, so arduino-cli was the vehicle, with LiquidCrystal
    1.0.7 standing in for the fmalpartida fork named in platformio.ini.
    The toolchain caught one defect review had missed: publishWeight was
    declared void and used in a boolean test. Now returns bool.
    Reading the core caught a worse one that a build would never have found.
    The watchdog ceiling on this part is 5592 ms - getMaxTimeout is
    RL_16384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
2026-09-01 PLC #4: fix the psi conversion - third instance of the unfinished resolution change
    The coordinator's hypothesis was right and the instance was in a value this
    port publishes.
    pressureValue mapped from zero counts rather than from the sensor's
    1638-count live zero, so it reported 299 psi at true 0 psi and 2699 psi at
    true 3000 - an offset and a compressed span, wrong at both ends. On main it
    was display-only and easy to overlook. This port puts psi in the telemetry
    payload, which would have made it a knowingly-wrong number published to the
    broker. Now maps SENSOR_COUNTS_ZERO..SENSOR_COUNTS_FS.
    Also corrected the sensorVoltage map: 14-bit full scale is 16383, not 16384.
    Running total for t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
2026-09-01 PLC #4: bound the psi defect precisely, and record the audit's through-line
    No code change. Three documentation corrections.
    Verified and recorded that the WEIGHT was never affected by the psi
    defect: pressureValue is assigned at :364, published at :387, printed at
    :639 and appears nowhere else, while the weight comes from
    calFactor * (smoothedValue - tareValue) at :366 straight from counts, and
    kv calibrates against the same count span. The psi path is a leaf. Stating
    it that way round because the unqualified version invites a reader to
    distrust the calibration path, which was never at fault - and the narrow
    claim is the stronger one. It still matters because 299 psi on an idle
    loader read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
2026-09-01 PLC #4: A1 pin confirmed, USB console, EEPROM signature; first flash to hardware
    First run on real hardware. Board on /dev/ttyACM0, flashed and verified.
    - Transducer pin is A1, confirmed by Alex at the machine. main had A2;
    the r4_wifi_mqtt branch had A1 and was right.
    - Console mirrored to USB Serial alongside the HC-05 on Serial1, so a
    technician with a laptop can talk to the board. Deliberately NO
    while(!Serial) - that is C4, the worst line in the original firmware.
    Writes to an unopened CDC port are harmless; waiting for one is not.
    - EEPROM restore now carries a signature, and this was found by flashing
    rather than by review. The board came back with tareValue = 16256,
    c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
2026-09-01 PLC #4: T4 open-circuit detection does not work - A1 needs a pull-down
    Bench finding, and it defeats the feature as built.
    With NOTHING connected to A1, the board reads 4401 counts with 8 counts of
    jitter and reports sensor = ok, computing 632 psi from a floating pin. The
    open-circuit threshold assumes a disconnected input reads near 0 V. It does
    not - a high-impedance CMOS analog input floats on leakage and residual
    sample-and-hold charge and can sit anywhere, here near mid-rail.
    So the justification written into the firmware - a chafed wire is the
    likeliest failure on a tractor and previously read as no load - describes a
    defect the feature does not actually fix. A cut sensor wire would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
2026-09-01 PLC #4: correct a false persistence claim in OPERATOR.md
    OPERATOR.md told the operator that recorded weights stay in the tally
    through a power cycle and only the upload was lost. That is wrong and it is
    a reassurance, not merely an omission - it is the sentence someone relies
    on when deciding it is safe to key off, which is exactly the decision R1
    punishes.
    rT[] and queueBuf are plain RAM. Both are lost on any reset. Replaced with
    an explicit table of what does and does not survive, and the instruction to
    get weights off the machine first - sum and write them down, or stay in
    range until net reports queued = 0.
    Also corrected in the same file, same class: sm is not persisted and
    reverts to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
2026-09-01 PLC #4: fix R1 and R2
    Alex instructed drive-to-completion and confirmed src was not frozen to me.
    R1 - the watchdog fix did not reach mqttClient.connect(). Root cause was
    that wifiClient.setConnectionTimeout() was never called, so WiFiClient's
    _connectionTimeout sat at its default of 0 (WiFiClient.h:251) and the TCP
    connect was bounded only by MODEM_TIMEOUT = 10000 against a 5592 ms
    watchdog ceiling. Compounded by a missing WDT.refresh() before the connect,
    skipped whenever WiFi was already associated - the common case.
    Fixed by bounding every blocking layer and refreshing before each. The TCP
    and CONNACK timeouts are SEQUENTIAL inside one connect call because the
    library does the TCP conn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
2026-09-01 PLC #4: my first R1 fix was wrong; heartbeat watchdog fixes the steady-state case
    Correcting the record before anything else: the previous commit claimed R1
    was fixed and verified. It was not, and the verification was worthless. I
    tested with placeholder credentials, so association failed fast and the test
    never entered the path. I had written in the same report that nothing had
    exercised the live path, and still called it fixed. A test that cannot fail
    is not evidence.
    The moment Alex supplied real credentials the board reset-looped every 30 s
    against a real SSID, wiping the tally each time - four resets in 100 s.
    Root cause was the same error one layer down. CWifi::begin has THREE
    blocki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
2026-09-01 PLC #4: remove wifiClient.setConnectionTimeout - it broke the connect outright
    My R1 fix stopped the board reaching ANY broker, and I only found it because
    a reachable broker finally existed.
    wifiClient.setConnectionTimeout() looks like the obvious way to bound the TCP
    connect. It also silently selects a different AT command (WiFiClient.cpp:53):
    _connectionTimeout == 0 -> +CLIENTCONNECTNAME works
    _connectionTimeout != 0 -> +CLIENTCONNECT fails with a dotted-quad host
    Measured: mqttClient.connect() returned -2 MQTT_CONNECTION_REFUSED on every
    attempt while tcpdump on the broker saw ZERO packets - the connect failed at
    the coprocessor before any TCP was attempted. I had diag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
2026-09-01 PLC #4: bench bring-up - publish path verified, replay semantics measured
    First end-to-end run of the MQTT path against a live broker (Saga,
    192.168.5.241, anonymous, same subnet - mirroring farm1 not rata so the
    bench exercises what ships).
    Topic arrives complete and untruncated at its full 19 characters, which
    closes X1: the audit's truncation finding was inferred from source and is
    now observed on the wire.
    Backlog replay semantics, measured by holding the subscriber connected and
    dropping only the board with an iptables rule so the capture spans the
    outage:
    {"w":2772,"age_ms":74701,"backlog":true,...}
    {"w":2773,"age_ms":72119,"backlog":true,...}
    {"w":2769,"age_ms":69535,"backlog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
2026-09-01 PLC #4: find and fix the first-association reset
    Chased it rather than shipping with it open, since 'only at first
    association' is the signature of something that fires in the field and not
    on the bench - and this tractor makes a first association every key-on.
    Diagnosed with hardware rather than inference: the RA4M1 records its reset
    cause in RSTSR0 (power-on, brownout) and RSTSR1 (watchdog, software). Now
    read, decoded and cleared at boot, and reported on the net verb, which
    settles watchdog-versus-brownout directly instead of leaving two candidates.
    Mechanism: loopHeartbeatMs is stamped once per loop() pass, so everything
    netPoll does accumulates against one heartbeat. Both halves in th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
2026-09-01 PLC #4: add the keys verb - live keypad ladder sampler
    Reports raw A0 and the decoded button on every change for 15 s, so the
    ladder thresholds can be re-derived against the shield actually fitted
    rather than inherited from the uno-r3-swserial-lcd branch, where they came
    from originally.
    The decode is factored into keyName() and shared with the keypad handler,
    so the diagnostic and the live code can never disagree about what a reading
    means - which would make the diagnostic worse than useless.
    Keeps loopHeartbeatMs and the watchdog fed inside its own sampling loop,
    since 15 s exceeds the 5.6 s hardware watchdog period.
2026-09-01 PLC #4: menu-driven HMI - edge-triggered keypad, confirms, status on screen
    Addresses all six problems found in the old handler.
    Edge triggered, not level. The old code sampled A0 every 1000 ms and
    re-fired while held, so holding Right recorded duplicate weights and
    holding Select hammered EEPROM with re-tares. Now a press acts once, on the
    none->key transition, with 40 ms debounce.
    Home screen carries what the operator needs in order to trust the reading,
    worst first: CAL NOT SET when calibration was never stored or was rejected,
    then DROPPED, then queue depth with link state, then TALLY FULL and a
    low-space warning. Previously all of that was reachable only over the
    serial console, so a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
2026-09-01 PLC #4: persist the tally so the shield's RESET button cannot destroy it
    Alex confirmed the reset seen during keypad testing was the LCD shield's own
    RESET button, which sits in the same row as the five operator keys. A gloved
    thumb will find it in the field, and it wiped the whole tally with no
    confirmation and no undo.
    The tally is now written to EEPROM as it is recorded, with its own signature
    separate from the calibration block so clearing or rejecting one cannot
    silently discard the other.
    Written to cost as few EEPROM.put calls as possible, because put() on this
    core is a virtual EEPROM over data flash: it skips unchanged bytes but still
    erases and rewrites the whole block per CALL,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
2026-09-01 PLC #4: fix Up and Down on the home screen - both were near-useless
    Found by Alex simply asking what they did.
    Up ran the sum verb, which wrote the total to the LCD - and the home
    renderer overwrote it milliseconds later. There were TWO hold variables,
    lcdHoldUntil and msgUntil, and the renderer honoured only msgUntil, so the
    total was drawn and wiped without ever being seen. Up appeared to do
    nothing.
    Down ran net and displayed 'see console', which is useless in a cab. It
    told the operator to go and look at a serial terminal they do not have.
    Up now shows the total and the entry count on the LCD, held. Down shows
    WiFi and MQTT state with the queue and dropped counts - the two questions
    '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
2026-09-01 PLC #4: rTsum was unsigned - negative weights underflowed the total
    Surfaced while testing the new Up button: three entries of -5 totalled
    4294967281 instead of -15.
    outputValue goes negative below tare and on an uncalibrated board, so
    rTsum being 'unsigned int' turned any negative total into 2^32 minus the
    real value. The operator would have seen a ten-digit number on a 16-column
    display.
    Now a signed long, and the deferred Up message formats with %ld to match.
    This one is at least visibly absurd rather than plausibly wrong, which is
    the opposite of every other defect found on this machine - but it still had
    no business on the display. Verified: 3 x -5 now totals -15.
2026-09-01 PLC #4: transducer input is A2 as wired, not A1
    Alex confirmed the harness actually lands on A2. This flip-flopped, so the
    history is recorded at the declaration rather than left as a bare constant:
    main had A2, the r4_wifi_mqtt branch had A1, this file was briefly set to A1
    on an early answer, and A2 is what is wired. main was right all along.
    Every bench reading taken before this change was on a floating A1 and means
    nothing - including the 4401 counts that demonstrated the NO SENSOR defect.
    That finding still stands: it is a property of a floating high-impedance
    analog input, not of which pin it is, and the pull-down is needed on
    whichever pin the transducer lands on. Reworded the docs a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
2026-09-01 PLC #4: retained status topic and last will
    Answers 'does PLC4 report health'. Before this it published readings and one
    fault flag; it could not say whether to BELIEVE the readings, whether it had
    lost data, or whether it was alive.
    New retained plc4/jd5055e/status, QoS 1, published on connect and every 60 s:
    up, cal (ok|DEFAULT), sensor, tare, cf, n, q, dropped, uptime_s, rssi, reset
    cause, id. All of it was already known to the board and reachable only from
    the LCD or a serial console in the cab.
    Last will on the same topic, retained, payload {"up":false,...}. Without it
    silence is ambiguous - out of radio range, wedged, reset-looping and powered
    off all look identical. That is the fail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
2026-09-01 PLC #4: capture validity with the reading; verify the watchdog on hardware
    Two changes from estate-bridge's review of the payload contract, both cheap
    and both improving what the data can be trusted for.
    Backlog weights now carry sensor and cal AS AT CAPTURE, recorded into the
    queue entry rather than read at flush. Omitting them was right in that
    stamping CURRENT state on a historical record is a lie the ingest cannot
    detect - but it left every weight taken out of radio range unusable as data,
    on the one machine where being out of range is normal operation. Capturing
    them keeps the record honest AND resolvable. Verified on the wire:
    {w:-5,age_ms:61327,backlog:true,sensor:ok,cal:DEFAULT,..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
2026-09-01 PLC #4: document the keys and hang service verbs
    Both were added for diagnosis and neither was in the operator notes. An
    undocumented verb that reboots the board is worse than a documented one -
    someone will eventually type it and have no idea what happened.
    Recorded under a heading that says plainly they are not for the seat, with
    what hang actually costs: nothing but the pending uploads, because the tally
    and calibration are stored.
2026-09-01 PLC #4: correct an over-broad warning about what sm can rescale
    The comment said changing sm alone could not rescale a physically different
    transducer. That is wrong for the case that actually matters.
    SENSOR_COUNTS_ZERO and _FS are the counts for 0.5 V and 4.5 V - voltage
    endpoints. They do not move when the PRESSURE range does. So a 3500 psi unit
    with the same 0.5-4.5 V output needs only sensorMaxPSI changed; both count
    endpoints stay put. The warning applies to a different OUTPUT VOLTAGE range,
    such as the 1-5 V part considered earlier, where both do have to change.
    The live hazard was misidentified along with it. It is not the arithmetic -
    it is that sm is not persisted and reverts to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
2026-09-01 PLC #4: widen the secrets ignore to arduino_secrets*.h
    So a bench config and a farm config can sit side by side without either
    being trackable. The old pattern matched only the exact filename, so
    arduino_secrets.bench.h would have been committable - the kind of near-miss
    that only shows up once a real PSK is in it.
2026-09-02 PLC #4: count over-range samples in status
    plc4-dash found counts reaching 14958 in valid rows - above SENSOR_COUNTS_FS
    (14745, the assumed 4.5 V full scale), below SENSOR_COUNTS_SHORT (15400).
    That band currently reports sensor = ok and is invisible except by inferring
    it from psi arithmetic.
    status now carries overrange (a count) and overrange_max (the highest counts
    seen). Deliberately NOT a sensor state: an over-range sample is still a
    reading, and routing it through sensorState would have blocked recording,
    taring and calibrating via the T4 guards - wrong response to a pressure
    spike.
    Worth stating why the excursion was visible at all: Arduino map() does not
    clamp, so psi extrapolates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
2026-09-02 PLC #4: alpha could condemn a good calibration - two bugs, one live fault
    Found by plc4-dash asking whether cal resetting to DEFAULT on reboot, while
    cf and tare survived, was deliberate. It was not. It is a bug, and it caused
    a real recalibration in service.
    BUG 1 - the signature vouched for a slot that was never written. alpha at
    addr+8 was written ONLY by the w verb, while tare, kv, c and the undo-tare
    path each wrote their own field plus the signature at addr+12. On a board
    where w had never been used, the signature said the block was valid and
    alpha read back 0xFFFFFFFF - NaN as a float.
    BUG 2 - alpha's validity was conflated with the calibration's. The NaN
    failed the range test, set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
2026-09-02 PLC #4: write up field commissioning and the overnight hold test
    First findings against a real transducer on a real machine.
    The transducer spec is CONFIRMED against hardware. Predicted live zero 1638
    counts; measured tare at the mark with an empty bucket 1806, and the
    168-count gap is 38.5 psi of boom weight. A wrong zero would not have landed
    168 counts from the prediction. The T-series arithmetic is no longer
    provisional. Recorded what this does NOT confirm: the span, which
    single-point calibration absorbs exactly and which only a datasheet can
    settle.
    The circuit reaches the ADC rail in normal work - 14958 counts then a pinned
    16383, single excursion with the boom being actively worked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
2026-09-13 PLC #4: 4-20 mA loop - settled decisions, and the defect at the top of the range
    Brainstorming record for feat/plc4-4-20ma-loop. No firmware edited.
    Settled: dedicated 24 V loop supply, 150 ohm 0.1% burden across A2 to GND, and
    Alex's ruling that the circuit really does exceed 3000 psi.
    150 ohm is decided on hardware survival, not measurement. Resolution binds on
    nothing - every candidate from 100 to 250 ohm is 52-131x finer than the sensor's
    own +/-1.0% FS. Compliance binds on nothing at 24 V. What binds is that PLC #3
    metered a 29.7 mA hard-over (playbook s10): against 200 ohm that puts 5.94 V on
    the pin, 0.94 V over AVCC and into the ESD clamp. 150 ohm holds to 33.3 mA.
    250 ohm is rejec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
2026-09-13 PLC #4: record four rulings, and a range contradiction that is not mine to resolve
    Approved by Alex 2026-09-13: mA as the source of truth with counts derived at
    compile time; bump EEPROM_SIGNATURE and force a recalibration; freeze the filter
    on fault so a dead loop holds its last reading instead of decaying to a plausible
    zero. Those three are settled and recorded against his name.
    The fourth is not settled, and the file now says so rather than picking. Alex
    ruled earlier today to assume the circuit exceeds 3000 psi and to size with real
    margin above 3000, then named a Rosemount 1151 at 0-3000. A 0-3000 part has no
    margin above 3000. Both statements are his, neither is withdrawn, and a part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
2026-09-13 PLC #4: 4-20 mA firmware design, and close the range question
    Range settled by Alex: Rosemount 1151, 0-3000 psi, sensorMaxPSI = 3000. Mounting
    and installation are out of scope, also his ruling. The decisions file's s5 is cut
    back to the settled answer plus the one consequence worth carrying: the circuit
    reaches past span routinely, so the loop will sit in the 20.0-21.0 mA band during
    excursions. That publishes as SENSOR SHORT today and reads as a broken wire; under
    the new banding it publishes as SATURATED, keeps reading, and increments overrange.
    The scale is still pinned during each excursion - what changes is that they become
    a counted, published quantity instead of a false alarm, and ov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
2026-09-13 PLC #4: implementation plan for the 4-20 mA loop, with its arithmetic pre-verified
    Eight tasks against MA-LOOP-DESIGN.md. The plan is honest about what can be
    checked here and what cannot: PlatformIO is not installed, arduino_secrets.h is
    absent and no board is tethered, so Task 0 is an optional prerequisite that
    installs a toolchain and proves the UNTOUCHED baseline builds before anything is
    edited. Without that baseline a failure after Task 2 is ambiguous. If Task 0
    cannot run, the plan says to report "compiled: NOT VERIFIED" rather than fake a
    build step - a firmware change with no compile check is how a duplicate
    enumerator value once reached production on this estate.
    Task 1 is the exc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
2026-09-13 PLC #4: this repo compiles, and now there is a one-liner that proves it
    CLAUDE.md says nothing here has been compiled or flashed. That is stale. Saga
    carries arduino-cli 1.5.0 with arduino:renesas_uno 1.6.0, Alex confirms the
    estate has been flashing with it, and the untouched baseline at 7e7f2f4 builds:
    85008 bytes flash (32%), 11196 bytes RAM (34%). PlatformIO is not installed and
    is not needed, despite the tracked platformio.ini.
    tools/build-check.sh bridges the layout mismatch - the repo is PlatformIO-shaped
    (src/*.cpp) and arduino-cli wants a sketch directory containing <name>.ino - by
    assembling a throwaway sketch in a scratch dir. It never opens a port and takes
    no upload flag. Flash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
2026-09-13 PLC #4: derive the 4-20 mA thresholds instead of hand-writing them
    Milliamps are the source of truth; counts come from a constexpr against
    BURDEN_OHMS, so changing the burden moves every threshold and nothing is
    hand-derived. This file has three documented cases of exactly that going stale
    when the resolution changed (:914-919 names all of them).
    Host-checkable with g++ because nothing else here can be run: no toolchain for
    the target is installed and no board is tethered. It proves arithmetic and
    claims nothing about hardware.
    Five states replace three. SATURATED is a measuring state, which is the whole
    point: 20.0-21.0 mA is over-range-but-still-measuring under NE43, and today a
    real pre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
2026-09-13 PLC #4: five loop states replace three, and SENSOR_SHORT retires
    A current loop is current-limited and has no rail to short to, so SENSOR_SHORT
    described a condition that can no longer occur -- while the thing it was firing
    on, a real pressure excursion past span, had no state of its own. That is the
    defect: over-range was counted only in a narrow band below the short threshold,
    so genuine excursions published as a wiring fault AND went uncounted.
    SATURATED now carries them and increments overrange, so overrange_max finally
    measures how far past 3000 psi this circuit goes.
    The operator-action guards (tare, +, kv) stay strict on LOOP_OK: a pinned or
    below-zero reading is not a valid basis f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
2026-09-13 PLC #4: rewrite the stale psi-conversion comment for the current loop
    The comment above countsToPSI() still described the 0.5-4.5 V ratiometric
    front end, including the last remaining SENSOR_COUNTS_ZERO/FS reference in
    the file. The conversion call itself was already ruled into Task 2 (365dace)
    because Task 2 deleted the constants it depended on; this commit only
    brings the comment back in line with what the code now does.
    The new text keeps the two facts that mattered before: the conversion still
    starts at the live zero (4 mA), not zero counts, and pressureValue is still
    published as psi, not display-only. It updates what changed: rescaling to a
    different pressure range now needs `sm` alon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
2026-09-13 PLC #4: hold the last reading on fault, and refuse a stale calibration
    Both approved by Alex 2026-09-13 as specific changes to the weight path.
    The filter was fed unconditionally, so a dead loop decayed the weight smoothly
    to a plausible number rather than stopping -- it reads as a load being set down.
    Guarded by loopIsMeasuring(), NOT by != LOOP_OK: a saturated reading is real and
    must keep feeding the filter.
    EEPROM_SIGNATURE goes to PL4A because counts-per-psi moved 1.67x, so a
    voltage-era tare and factor would restore clean, pass the bounds check and
    publish cal:ok over a scale wrong by that ratio -- the failure the signature
    exists to catch and the old value would miss. The board now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
2026-09-13 PLC #4: psi publishes null, not zero, and the loop current goes on the wire
    Null is not zero at every layer (playbook s6): a real zero and a dead
    transmitter are different things. psi_fault carries the direction because
    fail-low is a wiring question and fail-high is not, and they lead to different
    first checks at the machine. Both field names match PLC #3 so the estate reads
    the same way. mA is what a person with a meter is comparing against, computed
    from sensorValue (the raw mean) so it agrees with the counts field beside it.
    payload[128] at the telemetry site grows to 192. Measured worst case with the
    real argument types (w as a full int, not int16) is 129 bytes -- w at
    INT_MIN plus a 5-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
2026-09-13 PLC #4: queueFlush stops fabricating a healthy sensor state on replay
    Regression this branch introduced, not a pre-existing defect: before the
    5-state LoopState migration, queueFlush()'s local 3-entry names[] array
    matched the then-3-value enum exactly. That migration started storing the
    5-value loopState into the same byte without updating the array, so every
    buffered reading captured while LOOP_SATURATED or LOOP_FAULT_HIGH clamped
    through `sensorAtCapture <= 2 ? ... : 0` and replayed to the broker as "ok".
    LOOP_UNDER also mapped to "SENSOR SHORT", a string that must no longer exist
    anywhere. sensorAtCapture exists precisely so validity is a historical fact;
    this turned it into a fabricated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
2026-09-13 PLC #4: a pinned transmitter no longer blanks the operator's weight
    hmiDrawHome hid the weight whenever the state was not ok. Under five states that
    would blank the display every time the circuit went over range -- which the owner
    reports is routine -- and withholding a weight because the transmitter is pinned
    is the defect this front end replaced, not a safeguard.
    Row 0 now keys on loopIsMeasuring(), so only NO SENSOR and XMTR FAULT take it.
    SATURATED and UNDER ZERO stay visible in telemetry and in the counters.
    Claude-Session: https://claude.ai/code/session_01GdM9e5Jz5GFvcKoR9xHcng
2026-09-13 PLC #4: print the loop current beside the millivolts
    mA is the unit a person at the machine is comparing against a meter. mV stays
    because it is the direct check that the burden resistor is the value it is
    supposed to be -- which is now a calibration term and was not before.
    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
2026-09-13 PLC #4: document the loop front end for the operator and the brief
    SENSOR SHORT is gone from the LCD; XMTR FAULT and NO SENSOR replace it as the
    two states that blank the weight, and BAD STATE (corrupted record, should
    never appear) is documented too. SATURATED and UNDER ZERO are telemetry-only
    and deliberately never reach the display, so the operator is told that rather
    than left waiting for one.
    Records that the board demands a full recalibration after flashing (CAL NOT
    SET! on row 1), and why: the stored calibration belongs to the old front end
    and is wrong by ~1.67x. Records that tare, + and kv refuse unless the loop
    reads ok, naming the state, including when it is SATURATED.
    BRIEF.md'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
2026-09-13 PLC #4: the Check cal screen can no longer hide a dead transmitter
    hmiPoll() returns on SCR_CHECKCAL before it ever reaches hmiDrawHome(), and
    hmiDrawHome() was the only place a fault took row 0. So Menu -> Check cal
    printed outputValue unconditionally: loop supply fuse blows, the operator
    opens Check cal, reads "Should be 530 / Reads 528", and signs the scale off
    with the transmitter disconnected. There is no timeout on that screen; only
    Left or Select leaves it.
    The filter freeze added earlier in this branch made it worse rather than
    better. A held weight that is rock-steady looks more trustworthy than one
    visibly decaying toward the tare.
    hmiDrawCheckCal() now shows sensorStateName() on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
2026-09-13 PLC #4: the keypad stops reporting success for verbs that were refused
    All three refusals printed to the console and nothing else reached the
    operator. `+` refused on `loopState != LOOP_OK`, wrote the state to LCD row 1,
    and then the deferred pendingMsg path painted "Added 4200" / "17 in tally"
    straight over it. `tare` and `kv` were worse: hmiOnPress painted "Tare taken"
    and "Calibrated" BEFORE the verb ran, so their refusals never touched the LCD
    at all.
    This branch is what makes it everyday rather than exotic. Before it, an
    over-range sample fell through to SENSOR_OK and `+` was allowed; it now
    refuses on LOOP_SATURATED, and the owner reports over-range is routine. So a
    false "Added" on a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
2026-09-13 PLC #4: one AVCC, not two
    include/loop_scaling.h had ADC_VREF_V feeding every derived count threshold
    and countsToMilliamps(); this file separately had `float vReference = 5.0`
    feeding the millivolt print. Same number, two places.
    That matters here specifically. AVCC is flagged in the header as an UNMEASURED
    DIRECT GAIN TERM: the old transducer was ratiometric so AVCC error cancelled,
    and a burden resistor does not cancel, which makes 5.0 the single constant
    most likely to be corrected the first time someone puts a meter on the rail.
    With two copies, correcting one would have left the printed `mA` and the
    printed `v` describing different rails, silently — and `v` is the direct check
    that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
2026-09-13 PLC #4: false success on a failed cal and a full tally, not just a refused verb
    Extends the verbRefused mechanism (68dc5a8) to two more paths where a
    refusal/failure was reported to the console and LCD row 1, then painted
    over by the deferred success message: kv when span<=0.0f ("Calibrated" /
    "check it now" over a calibration that did NOT write calFactor), and + when
    the tally is full ("Added <n>" over a record that was never taken).
    Adds verbRefusedReason, empty by default (falls back to sensorStateName(),
    unchanged for the three pre-existing loop-gated refusals) and set only at
    the two new failure sites, since neither failure is a loop state: "at or
    below tare" for kv, "TALLY FULL" for a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
2026-09-13 PLC #4: the implementation record for the 4-20 mA loop
    Companion to the decisions note and MA-LOOP-DESIGN.md, written so the next reader
    does not need a session transcript. Implemented and compiled; NOT flashed, no
    board tethered, every runtime claim read from source and labelled as such.
    Records that this repo compiles now, which is new: arduino-cli on Saga, not
    PlatformIO, via tools/build-check.sh. 85008/11196 baseline to 85668/11216 here.
    Records both defects closed, with the traces. An open loop reads ~0 counts
    against the burden instead of floating mid-rail as healthy; a 20.5 mA excursion
    is a counted, published SATURATED state instead of a wiring fault. And it names
    the two predicate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
2026-09-13 PLC #4: record the flash gate Alex set on the consumer
    Asked explicitly about ordering and he chose it: greybeard-plc-consumer#5 is
    updated BEFORE this firmware is flashed. That consumer nulls w and psi whenever
    sensor != "ok", which now includes SATURATED - so flashing first would have the
    ingest silently discard the first stretch of over-range excursions, which is the
    one measurement this whole feature exists to produce and the one nobody has ever
    had. Recorded as a gate rather than a recommendation, and recorded as NOT STARTED
    so the next reader does not assume it was done.
    Also records his acknowledgement of the flash order: transmitter fitted first.
    PLC #3's playbook makes that a proce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
2026-09-13 PLC #4: name the branch of record
    feat/plc4-4-20ma-loop-impl carries everything; feat/plc4-4-20ma-loop is a
    redundant pointer at one of its ancestors, so the work is not split. A
    fast-forward to unify the names was approved but a repo guard reserves merges
    for the session owning the repository root. Left rather than worked around with
    a different command - the guard expresses an intent, not just a syntax ban, and
    the only thing the merge would have changed is a branch name.
    Recorded because the next reader will otherwise see two branches and have to
    work out which one to read, review or flash from.
2026-09-13 PLC #4: deployment runbook for the agent that installs the firmware
    Alex ruled that the agent installing the firmware performs the migrations, so
    the sequence needs to live somewhere that agent will find rather than in a
    session transcript.
    Leads with the ordering constraint that bites first, because it is not obvious
    and it takes the estate's only ingest down: the new consumer builds its required
    column set by PARSING its own INSERT statements, and those now name psi_fault,
    ma and underrange. require_schema() asserts them at start-up and raises on a
    missing column explicitly as a non-transient condition, so deploying the
    consumer before migration 061 makes it REFUSE TO START. Fails safe, b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
2026-09-14 PLC #4: both remotes are intended, and the never-push rule was a miscommunication
    Alex, 2026-09-14: "it was a misscommunication in the chat that created the
    prompt please push", and "it should have a gh remote and a saga remote".
    The old text said origin is Alex's upstream GitHub repo and must never be pushed
    to. It was written 2026-09-01 and never edited, and it reads exactly like a rule,
    so it was obeyed as one. It cost real caution: a session held the entire 4-20 mA
    feature off GitHub on the strength of it, and could not tell from the repository
    whether the rule named origin or the remote now called upstream - the plc4 GitHub
    repo was created ten minutes BEFORE the line was written, whic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
2026-09-14 PLC #4: file the 520M spec sheet, and say plainly whose tractor it describes
    Alex supplied this during the 4-20 mA work as the answer to "what is the M520
    circuit's relief pressure". Committing it so the figure everything was weighed
    against is in the repository rather than in one session's scrollback.
    READ THE CAVEAT BEFORE USING ITS NUMBERS. The sheet's Tractor block says
    "Model - 5085E, 5090E, 5100E FT4". This machine is a 5055E. Pump capacity and
    rated pressure are properties of the TRACTOR's hydraulic system, not the loader,
    and the 520M is sold across several chassis - so the sheet's Rated Pressure of
    2828.0 psi and Pump Capacity of 11.0 gpm are a 5085E/5090E/5100E's figures. They
    are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
2026-09-16 PLC #4: the machine is benched for the upgrade
    Alex, 2026-09-16: "I'll be installing the hardware in the next few days,
    currently the system is unusable with the current sensor so we will be benching
    the plc4 for upgrades."
    Recorded because the agent that installs the firmware will read this runbook and
    would otherwise assume it is deploying against a live scale. There is no running
    machine to protect and no working measurement to regress, which removes the time
    pressure and makes getting the ORDER right worth more than getting it done.
    It also corroborates the open contradiction in the decisions note s3 without
    settling it: the reason the machine is unusable is the same reason 2828 psi an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
2026-09-16 PLC #4: design the MCP3421 loop ADC, the 20x4 display and discrete buttons
    Prior art is Alex-Pennington/LogSplitter_Monitor, which runs all three on the
    SAME board in production. Ported reasoning, not invented.
    The MCP3421 is NOT for the resolution - the resolution actually drops. It is for
    the REFERENCE. Issue #4 records AVCC as a direct gain term never measured: the
    retired ratiometric part tracked AVCC so the error cancelled, a burden does not,
    and the R4's ADC references a rail that sits anywhere in 4.75-5.25 V - up to +/-5%
    against a transmitter rated +/-1.0% FS. The MCP3421 carries its own 2.048 V
    reference, so the board rail leaves the measurement. That closes #4 by
    construction rath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
2026-09-16 PLC #4: implementation plan for the MCP3421, the 20x4 display and buttons
    Eight tasks plus a baseline, each leaving the tree compiling. Band edges and
    conversions were compiled and run before handover: all ten classifier edges
    correct, 4 mA and 20 mA landing exactly, psi floor and extrapolation right, and
    countsToPSI's worst case 142,060,000 against a 32-bit long.
    Leads with a DATASHEET CORRECTION, because the plan tells an implementer to port
    a driver from LogSplitter_Monitor and two of that header's constants are inverted
    against Microchip DS22003E. RDY when reading is 0 = result IS ready, not the
    reverse; and O/C bit 4 = 1 is continuous, not one-shot. Ported blind, the driver
    runs one-sh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
2026-09-16 PLC #4: derive the loop thresholds against the MCP3421 reference
    68 ohm burden and a 2.048 V reference replace 150 ohm and AVCC. Every threshold
    re-derives from the two hardware constants, which is what the mA-as-source-of-truth
    design was built for.
    The old 150 ohm cannot be used on this ADC: 2.048/150 clips at 13.65 mA, below the
    20 mA span end. 68 is the largest E24 value keeping the 29.7 mA hard-over PLC #3
    actually metered on scale.
    14 bits is a RATE choice - 18-bit is 3.75 SPS and this firmware samples every
    50 ms, so 18-bit would take 2.7 s per reading. Still 43.5x finer than the sensor.
    Expected values: COUNTS_DEAD=952, COUNTS_ZERO=1088, COUNTS_FS=5440, COUNTS_FAULT_HIGH=5712.
    Tes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
2026-09-16 PLC #4: fix Task 1 — remove incompatible shim, use correct MCP3421 display formula
    Remove the backwards-compatibility shim that defined ADC_VREF_V and ADC_FS
    in loop_scaling.h. The plan requires them deleted entirely.
    The shim's values were wrong:
    - ADC_FS = 16383 misrepresented the MCP3421's signed 14-bit range (−8192..8191)
    - The combination of old and new constants in sensorVoltage calculation silently
    halved the displayed voltage
    Replace the sensorVoltage calculation in ArduinoHydraulicScale.cpp with:
    sensorVoltage = (int)(sensorValue * MCP3421_LSB_V * 1000.0f);
    This uses the MCP3421's LSB from the reference, binding display to thresholds
    in one place. A single edit in loop_sc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
2026-09-16 PLC #4: MCP3421 driver on Wire1, with the datasheet polarity right
    Ported in structure from LogSplitter_Monitor, but TWO of its constants are
    inverted against Microchip DS22003E and are corrected here: RDY=0 means the
    result IS ready, and O/C bit 4 = 1 is continuous mode. A driver carrying the
    sibling's values runs one-shot believing it is continuous and accepts only stale
    samples.
    A failed I2C read returns false and is counted. It is NOT reported as zero
    counts - zero counts is LOOP_DEAD, an affirmative claim the loop is open.
    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
2026-09-16 PLC #4: read the loop from the MCP3421, not the internal ADC
    A2 is now free and the measurement no longer depends on the board's supply rail.
    A failed I2C read does not advance the sample count - averaging fewer good
    samples is right; counting a failure as a sample is not.
    Seeds the filter to COUNTS_ZERO rather than 0, because 0 classifies as LOOP_DEAD
    and a board booting before the first conversion would otherwise announce a dead
    loop for one cycle.
    Also removes the A2-wiring history comment and the resolution-ordering comment
    at the old seed line: both explained reasoning for analogRead/analogReadResolution
    calls that no longer exist in this file, and leaving them would misdescribe the
    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
2026-09-16 PLC #4: LCD2004A driver on Wire1, direct I2C
    Ported from LogSplitter_Monitor, which drives this display on this board without
    LiquidCrystal_I2C, deliberately, for full control.
    Records that the backpack is typically a 5 V part on a 3.3 V Qwiic bus. I2C is
    open-drain so it generally works and the sibling runs exactly this combination,
    but that is proven on another machine and not measured here.
    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
2026-09-16 PLC #4: 20x4 display, and the fault row belongs to the display layer
    Row 3 is written on EVERY render regardless of screen, so a screen added later
    cannot silently opt out of fault indication the way SCR_CHECKCAL did. That was
    the Critical in the 4-20 mA review: a dead transmitter was invisible on the
    calibration-check screen, and freezing the filter had made the stale reading
    rock-steady rather than visibly decaying.
    The transient-message path renders it too - a toast must not outrank an alarm.
    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
2026-09-16 PLC #4: discrete buttons replace the shield's resistor ladder
    The keypad was part of the 16x2 shield and left with it. keyIndex() is the whole
    seam: it still returns 0..4 or -1 and the proven debounce and act-on-press-only
    logic is untouched.
    Scans in fixed priority and returns the FIRST pressed key, because a ladder could
    only ever report one and everything downstream assumes one-or-none - two
    simultaneous presses would otherwise present as chatter between two stable values.
    Removes every analogReadResolution flip. Nothing now shares an ADC between a
    keypad and a sensor, which retires a trap documented three times in this file.
    Clau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
2026-09-16 PLC #4: signature to PL4B, and publish the I2C failure count
    Counts-per-psi moved from a 7864-count span to 4352, so a PL4A calibration
    would restore cleanly and read wrong by that ratio. A full recalibration
    after flashing is the intended cost.
    i2c_err makes a degrading Qwiic bus visible before it is total. The I2C bus
    is now a single point of failure for the measurement AND the display, which
    it was not when the ADC was internal.
    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
2026-09-16 PLC #4: document the 20x4 display, the buttons and the 68 ohm burden
    OPERATOR.md: the display is now 20x4 with row 4 a permanent status row,
    written on every screen, showing loop state / CAL NOT SET! / an I2C error
    count and otherwise blank. The keypad is five discrete buttons, no longer
    part of the display shield. Records that the MCP3421 front end moved
    counts-per-psi again (7864 to 4352 counts), so CAL NOT SET! fires again
    after this flash and reads wrong by roughly 1.8x if ignored.
    Marks the "NOTHING YOU RECORD SURVIVES A POWER CYCLE" section as
    superseded, dated, rather than deleting it: the tally is in fact
    persisted (tallySaveEntry/tallySaveIndex/tallyRestore, TALLY_SIGNATURE),
    confi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
2026-09-16 PLC #4: mark the 150 ohm burden superseded in the design and decision docs
    Task 8 moved the operator doc and deploy runbook to the MCP3421's 68 ohm
    burden but did not reach MA-LOOP-DESIGN.md, BRIEF.md, or the decision
    register, which still specified 150 ohm as the part to fit -- a copy-paste
    trap that clips at 13.65 mA on this ADC and reads a two-thirds load as full
    scale, silently. Every mention is now dated and marked superseded rather
    than deleted; 150 ohm was correct for the AVCC-referenced ADC and was
    retired by the hardware change, not by an error.
    Comment-only in src/ArduinoHydraulicScale.cpp; no other code touched.
    Build unchanged at 90816 bytes flash / 13440 bytes RAM. Host suite
    (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
2026-09-16 PLC #4: blank the weight on a dead or faulted loop, not just row 3
    The final review found the branch had dropped the guard on row 0: a
    LOOP_DEAD or LOOP_FAULT_HIGH loop froze the filter (by design, to avoid
    a smooth false descent) but the home screen kept showing that frozen
    weight as a steady, current-looking number, with only row 3 naming the
    fault underneath it. The spec's no-suppression exemption is for
    SATURATED and UNDER ZERO only -- both still-measuring states -- and
    loopIsMeasuring() is exactly that predicate. Restore the guard so row 0
    blanks to sensorStateName() whenever the loop is not measuring, matching
    hmiDrawCheckCal() and the promise in OPERATOR.md. Correct the filter-freeze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
2026-09-16 PLC #4: a stale ADC now says NO ADC, not a frozen "ok"
    If mcpRead() keeps failing, loopState/sensorValue/outputValue held forever
    at their last value, LOOP_OK included -- so the weight, the display and the
    telemetry all kept reporting a frozen reading as a healthy live one. A loose
    Qwiic connector produced a completely clean, unmoving screen.
    Adds a third, orthogonal predicate to the two loop_scaling.h already keeps
    distinct (may the operator act / may we trust the reading): is the reading
    fresh. readingFresh() checks millis() since the last successful mcpRead()
    against READING_STALE_MS (2000 ms, four sample cycles). readingTrustworthy()
    and operatorMayAct() compose it in once each; nine ca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
2026-09-16 PLC #4: a held button can no longer fire on release, or get stuck and kill the keypad
    Three defects Alex asked to have fixed, all in the keypad and home-screen
    tally warning:
    Rollover into release fired an action the operator never asked for. Hold
    Up, press Right (fires, arguably fair), then release Right while still
    holding Up: keyIndex() falls back to Up and the edge detector fired Up
    again, on a release, with no button newly pressed. On the home screen a
    phantom fire is an unintended tare or tally entry with a bucket in the
    air. hmiPoll() now captures the previous stable key and only calls
    hmiOnPress() when the new key is non-negative AND the previous stable key
    was none -- a press is in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
2026-09-16 PLC #4: document NO ADC, clean-release buttons, and the tally warning
    OPERATOR.md's fault row and keypad sections didn't cover what the last two
    commits changed at the machine: a stale ADC now shows NO ADC (distinct from
    NO SENSOR -- different cable, different first check), a held button no
    longer fires on rollover or release (press one, let it come up, then the
    next), a button stuck past 10s is ignored and flagged KEY STUCK instead of
    deadening the other four, the tally warns at 5 left before it hits TALLY
    FULL, and the fault row's worst-first priority order is now spelled out. All
    additions go into the live first half of the file; the pre-existing
    duplicated/superseded second half (issue #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
2026-09-16 PLC #4: an intermittent Qwiic contact can no longer hide behind "fresh"
    Four defects from the Task 9/10 review (review-9-10.md), fixed in the source
    they were found in:
    - F1 (high): the freshness clock stamped on every successful mcpRead(), not
    on a completed sample cycle, so a contact succeeding once per ~1.9 s kept
    readingFresh() true forever while the displayed weight was up to 19 s old
    -- rock-steady, LOOP_OK, recordable with `+`, published "stale":false.
    Rename lastGoodSampleMs to lastReadingMs and stamp it inside the
    sampleN >= SAMPLE_COUNT block instead, so it certifies the reading, not
    the ADC.
    - F2 (medium): `net` and `read` are reached over the cab's HC-05 Bluetooth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
2026-09-16 PLC #4: a retained "ok" can no longer outlive the ADC that said it
    publishStatus() is retained/QoS1, so a board whose MCP3421 died could
    publish sensor:"ok" once and the broker would hand that claim, unchanged,
    to every subscriber that connected afterward -- with the fault visible
    only by inferring it from i2c_err. Add the same bare-boolean stale field
    telemetry already carries, in the same spot right after sensor, so status
    and telemetry agree and a late subscriber sees stale:true on connect
    instead of a stale claim of health.
    Worst-case payload length checked by hand (32-bit int fields, unsigned
    long fields at their max, resetCause at its 39-char buffer cap): ~353
    bytes including the null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
2026-09-16 PLC #4: one operator page, and it no longer contradicts itself
    OPERATOR.md carried its own body twice. The second copy ended in a section
    headed "NOTHING YOU RECORD SURVIVES A POWER CYCLE" which described firmware
    from before 163365d made the tally persistent, and it flatly contradicted the
    correct table earlier in the same page. An operator reading top to bottom was
    told the tally survives, then told it does not, with the "no" last and in
    capitals.
    The surviving copy is the correct one, confirmed against the firmware rather
    than against either section: tallySaveEntry() and tallySaveIndex() write each
    weight to EEPROM as `+` runs, and tallyRestore() reads them back in setup()
    behind TALLY_S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
2026-09-17 PLC #4: everything is behind an I2C mux, and two networks instead of one
    Bring-up on the bench found the MCP3421 and the LCD both absent from Wire1.
    Neither is faulty: the board carries a TCA9548A at 0x70 and every device sits
    behind it, invisible until its channel is selected. Read off the hardware:
    ch0 0x67 (unidentified) ch1 0x2A NAU7802 load cell
    ch2 0x40 INA219 volts+amps ch3 0x68 MCP3421, the loop ADC
    ch7 0x27 LCD2004
    The two drivers now select their channel at each entry point -- once per
    mcpRead and once per lcdLine, not per byte -- through include/i2c_mux.h, which
    caches the last selection and skips the redundant write. `sensor` went from
    NO ADC to NO SENSOR on t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
2026-09-17 PLC #4: read the INA219 on mux ch2, and say what it is and is not
    The spare power monitor on the LogSplitter_Monitor hardware is now read: bus
    volts and shunt millivolts every 2 s, on the status payload as `vbus`,
    `shunt_mv` and `ina_err`, and on a new `pwr` verb.
    Two deliberate refusals, both about not manufacturing confidence:
    CALIBRATION IS NOT USED. The INA219's current and power registers need its
    calibration register programmed from the shunt resistance, and a wrong value
    there yields confident wrong amps. This reads the SHUNT VOLTAGE instead, which
    is calibration-free, and divides by INA219_SHUNT_OHMS in one visible place.
    That constant is an ASSUMPTION -- 0.1 ohm, what the common b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
2026-09-17 PLC #4: name every mux channel, and say where NOTHING FOUND points
    All five channels are now identified from both sides -- Alex read them off the
    harness and the `i2c` scan found the same map independently. ch0's 0x67 is an
    MCP9600 thermocouple amp; ch1's 0x2A is the NAU7802 load cell. Neither belongs
    to any code here.
    Also records the thing that cost time on the bench: the mux sits on the trunk,
    ahead of every channel, so "NOTHING FOUND" means the trunk or the mux and never
    a device behind it. Both the ADC and the display went silent together and the
    instinct was to look at the ADC; the fault was one level up.
    Claude-Sessi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
2026-09-17 PLC #4: give the machine a binder, starting with the loop wiring
    The loop wiring existed only as spec fragments across a design note, a brief
    and a decision register, and there was nowhere to look it up at the machine.
    Three cards, on the estate number map:
    00 architecture the machine, the measurement chain, why a current loop
    04 controller the board, the bus channel map, display and operator keys
    10 wiring transmitter, supply, burden, and the connections
    The wiring card carries the two things that destroy hardware if they are got
    wrong. The burden belongs in the return leg: fitted in the supply leg instead,
    the converter inputs sit at the full supply voltage and the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
2026-09-17 PLC #4: renumber the binder contiguously and stamp the firmware
    Three structural corrections, against the estate binder standard.
    Numbering runs 00, 01, 02 with no gaps. The first pass used the subject map
    from the LCARS schema -- 00 architecture, 04 controller, 10 wiring -- on the
    reading that a gap means the binder has nothing to say on that subject. The
    structure standard is the later authority and says the opposite: a binder
    silent on a subject does not reserve its number, the next card takes it, and a
    set with gaps is a structural defect.
    Front-matter takes the PLC #1 block shape: an H1, a kind line, then bold-key
    lines. The plain-colon line the cards opened with breaks that block and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
2026-09-17 PLC #4: drop the branch and commit keys from the binder manifest
    They are not in the manifest schema, the renderer derives the version from git
    and ignores them, and a committed commit key is stale on the very next commit
    -- a claim that drifts, which is the thing the binder rules exist to stop. The
    repo key goes with them for the same reason: not in the schema, read by
    The binding lives in git and in the render stamp. Audits, issues and briefs
    name the repo, branch and commit as text, where it can be current.
    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
2026-09-17 PLC #4: work the binder audit — six findings, four new cards
    Issues 9 through 14 from the structure audit.
    #12, the one that mattered most: the gate defaulted to PLC #1's firmware roots,
    so a fresh clone ran it, saw PASS, and had checked no identifier at all. The
    default is now this repo's src and include, and the policy text no longer
    describes another repo's accepted-residual file and another repo's card.
    #13: the console radio module had no terminals on the only pinout card. It now
    carries its terminals, its rate, and the thing that costs an afternoon — the
    pair crosses, so a straight-through pair is silent both ways while the board
    keeps weighing and the fault looks like a dead mod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
2026-09-17 PLC #4: publish the commit this firmware was compiled from
    The machine published no build identifier, so nothing downstream could tell
    which source made the image on the board. LCARS said so on every binder card:
    "AS RUNNING - PLC 4 PUBLISHES NO BUILD". PLC #1, #2 and #3 all publish one.
    `build` now rides on the retained status payload and prints once at boot.
    tools/gen-provenance.sh writes a gitignored header; the build path regenerates
    it and falls back to a committed sentinel, so a fresh clone or a tarball with
    no git still compiles.
    The two things this had to get right, both learned from PLC #1's version rather
    than rediscovered:
    A DIRTY TREE SAYS SO. A trailing +dirty means the image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
2026-09-17 PLC #4: report the build on `net`, where someone can actually ask for it
    The build identifier was published on the retained status topic and printed
    once at boot. Neither reaches a technician at the machine: USB re-enumerates
    after a reset and eats the boot banner, and the status topic needs a broker
    this board cannot reach from anywhere but the farm LAN.
    `net` is the query the operator page already tells them to type, so the answer
    belongs in its output. Confirmed on hardware: the boot line is unreadable over
    USB, so without this the field existed and could not be asked for.
    Claude-Session: https://claude.ai/code/session_0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
2026-09-17 PLC #4: stop the contract card collapsing the two predicates
    The card said a consumer treating anything other than `ok` as invalid "fails
    safe on all of them". It does not. It discards SATURATED and UNDER ZERO, which
    are real measurements -- over range and below the live zero -- and losing the
    over-range excursions is losing the thing this front end was fitted to capture.
    That is dropping data, not failing safe.
    The firmware header this card describes says so in as many words, and the card
    contradicted it: "they differ on LOOP_UNDER and LOOP_SATURATED: both still
    carry a real measurement... do not collapse the two predicates into one."
    The sensor table now says per value whether it is a re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
2026-09-18 PLC #4: the status payload was being truncated on the wire at 200 bytes
    Every status message was discarded by every consumer. The JSON was cut
    mid-token so it never closed, which costs far more than the fields that
    overflowed: up, cal, sensor, stale, tare, cf, n, total and every counter went
    with them. The topic is retained, so the broker was also handing that malformed
    message to each new subscriber as the machine's standing answer.
    The buffer at fault was not the one this file declares. `char payload[448]` was
    verified and has 353 worst case. The limit is in the library: beginMessage()
    without a size passes 0xffffffffL, which sets _txStreamPayload false and
    buffers the whole message into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
2026-09-18 PLC #4: the CAN pins are D10 and D13, and the keypad was never in the way
    Research and planning for getting J1939 engine data off the 5055E into the
    existing MQTT -> Postgres -> Grafana stack. No deployed firmware is touched:
    src/ is untouched, and the two sketches are proposals under sketches/.
    The premise this started from was that the R4's CAN peripheral sits on D4 and
    D5, which the tractor board uses for the Right and Up keypad buttons -- so the
    work looked like it needed the buttons moved or a second board. D4/D5 is the
    UNO R4 *Minima* mapping. On the WiFi it is D10 (CANTX) and D13 (CANRX), per
    variants/UNOWIFIR4/pins_arduino.h:155-156, and the firmware's only pinMode()
    calls are KEY_P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
2026-09-18 PLC #4: the buttons come out, the commands arrive over MQTT
    Five holes in an outdoor enclosure are five places water gets in, so the five
    discrete buttons are gone and every operator action now arrives from a phone
    app over MQTT. The LCD stays -- it sits behind a clear coverplate and costs no
    hole -- as a read-only readout. The console keeps every command it had, as the
    service and recovery path that works with no broker in range.
    WHAT GOES WITH THEM, accepted rather than overlooked: the menu, the confirm
    screen and the check-cal screen, all reachable only by button; UNDO TARE, which
    existed only in that menu and has no replacement; and the confirm gate on `b`,
    which is now a bare command.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
2026-09-18 PLC #4: the ack is QoS 0, and the comment said 1
    Comment only -- no code change, and the compiled size is unchanged. The
    contract block above cmdPoll() still described the ack as QoS 1 after the
    publish was changed to QoS 0, so the file contradicted itself two hundred lines
    apart.
    It now also records WHY, because the reason is not obvious and someone will
    otherwise "fix" it back: a QoS 1 ack spins in endMessage() waiting for a PUBACK,
    which ages the reading past READING_STALE_MS and makes the board refuse the
    operator's NEXT command. Tap record, next tap bounces. A lost ack costs nothing
    because the dedup ring makes a retry idempotent; a stalled weighing loop does
    not recover that cheaply.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
2026-09-18 PLC #4: CLAUDE.md said no board was tethered; one is, on the tractor
    Three claims in this file had gone stale and none of them read as stale --
    which is the whole problem. An instruction written in the present tense keeps
    reading as a live rule long after it stops being true, and the file already
    carries a scar from exactly that failure (the "never push to origin" line,
    which cost real caution for two weeks because nothing in the repo could tell a
    session it had been retired).
    1. "No board is tethered. Nothing here has been compiled or flashed." A board
    is on the tractor, in service, loop live, calibration stored, USB console
    on farm1. Read from source is no longer the only way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
2026-09-18 PLC #4: Cal Poly captured this same tractor model, and their data says I had three things wrong
    Alex pointed out that someone had open-sourced CAN work on the 5055E. Cal Poly's
    Tractor Hacking project (sponsored by iFixit -- not Berkeley, which is what I
    assumed first) published 44 captures and 330,653 frames from a John Deere 5055E
    under the MIT licence. Checking our decode against it cost an hour and found
    three bugs that the bench would have charged a day for.
    WRONG, AND NOW FIXED:
    - TP.DT is PGN 60160 (0xEB00), not 60417. I took 60417 from a published source.
    The corpus has 1491 frames on 60160 carrying sequence bytes 01, 02, 03, 04 and
    exactly zero on 60417. Shipped, this would ha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
2026-09-18 PLC #4: BRIEF.md's "real remaining work" was eight-ninths already done
    Closes #27, and goes well past it. BRIEF.md is the file CLAUDE.md tells every
    session to read first, and its status claims predated the 4-20mA port. The
    header had been updated to "DEPLOYED AND RUNNING" while the body still said
    the hardware was on a bench with no transducer connected.
    Thirteen corrections, all in the file's own "Superseded, DATE:" voice -- the
    original text stays and the correction is appended, because the reasoning in
    the originals is still worth reading and because silently rewriting history is
    how a file stops being trustworthy.
    The one that was worth the whole pass: the table headed "Base-independe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
2026-09-20 PLC #4: every image was stamped with the previous build's provenance
    tools/build-check.sh generated include/build_provenance.h AFTER the loop that
    copies headers into the scratch sketch, so the freshly generated header never
    reached the compiler. Each image carried whatever the previous run had left on
    disk -- or the "UNKNOWN" sentinel on a fresh clone, where the gitignored header
    did not exist at all.
    Measured on a clean tree at 608aebf5: the compiled sketch received
    #define BUILD_PROVENANCE "c601d792+dirty"
    four commits adrift and falsely marked dirty. The board publishes that string
    as `build` on the status topic precisely so a technician can ask what is
    running instead of assuming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
2026-09-20 PLC #4: record which broker this machine talks to
    CLAUDE.md names the broker as genuinely unknown and not inferable from source,
    so #28 asked for it to be confirmed and recorded where both sides can be
    checked. Alex answered directly on 2026-09-20: 192.168.10.99 is farm1's
    address and it is the one to use in the firmware. arduino_secrets.h.example:16
    already carries it and needs no change.
    Measured from Saga the same day and recorded with it, because the measurement
    is what stops the next session concluding the broker is down: the configured
    literal is UNREACHABLE from Saga, while farm1.internal (10.77.77.13) is open
    and carries the live retained plc4/jd5055e status anonymously. Two address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
2026-09-20 PLC #4: the overnight drift is hydraulic, and it is not every night
    Alex asked for the scale data since the last calibration to be looked at for
    stability, noting that the loader arms creep down overnight and drift the
    reading. Measured against plc1-db and a live capture on farm1.
    Short-term stability is excellent: 14 samples over 70 s span 2 counts, and
    quiescent hourly standard deviation across the record is 0.4 to 3.0. The
    transducer is neither noisy nor wandering.
    The overnight fall is real and it is hydraulic, not arithmetic: counts, psi and
    mA move together, 518 psi down to 350 between 02:00 and 07:30. The shape is a
    transient -- flat for eight hours, onset near 02:00, fastest around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
2026-09-20 PLC #4: OPERATOR.md becomes binder card 07
    Alex ruled 2026-09-20 that OPERATOR.md belongs in the binder as 07, settling
    the judgement call raised in #1 and left unruled when Tyr deferred it. Closes
    #30.
    This is a rewrite, not a move. OPERATOR.md was written as a change log as much
    as a reference: dated entries ("Added 2026-09-18", "Removed 2026-09-16"), a
    retraction of its own earlier text, an issue number, and an instruction to
    throw away an out-of-date printout. None of that is what the Maker builds the
    machine from, and the binder rules exclude all of it. The card states what the
    machine is and what the operator does; git holds the rest.
    What the card deliberately does NOT carry, becaus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
2026-09-20 PLC #4: the loopback proof for #19, and the method that says internal but means external
    Issue #19 asks whether Arduino_CAN actually receives on renesas_uno core 1.6.0,
    because the CAN_EVENT_RX_COMPLETE branch -- the only thing that enqueues into
    the ring buffer CAN.available() serves -- carries the comment "Currently driver
    don't support this. This is unreachable code for now." If that is accurate the
    whole R4 CAN path is dead and no decoding matters. This sketch settles it.
    Written and compiled only. NOT FLASHED and not run: the only R4 WiFi in the
    estate is the production scale, in service on the tractor.
    THE TRAP THIS SKETCH EXISTS TO AVOID, which nearly caught the test itself:
    enable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
2026-09-20 PLC #4: #19 is answered -- Arduino_CAN does receive, and the stale comment was stale
    Run on an UNO R4 Minima on Alex's desk with a jumper between D4 and D5.
    7 of 7 checks passed, reproduced across two flashes.
    [PASS] D4-D5 jumper D4 -> D5 follows (low reads 0, high reads 1)
    [PASS] CAN.begin CAN.begin(250000) returned true
    [PASS] enableInternalLoopback returned 1
    [PASS] extended-id round trip id, dlc and all 8 data bytes intact
    [PASS] standard-id round trip id, dlc and all 3 data bytes intact
    [PASS] multiple frames buffered sent 4, CAN.available() reports 4
    [PASS] no CAN error events no error events raised
    So CAN_EVENT_RX_COM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
2026-09-20 PLC #4: card 07 says tare, because that is the operation
    Alex, 2026-09-20: "i am learning the difference between zero and tare. the
    operator tares before each operation." The card had been written using the two
    words interchangeably, which was my conflation and not his.
    Twelve uses of "zero" become "tare" -- the step in the weighing table, the
    stored value that survives a power cycle, the thing that cannot be stepped
    back, and the refusal wording. None remain: the card now uses one word for one
    operation.
    The distinction matters at the cabinet. A tare is an operation the operator
    performs at the boom mark before each weighing session, and the stored result
    of it. Calling it "the zero" invi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
2026-09-20 PLC #4: how to take a PGN census off the tractor with the RH-02
    The sequence someone follows, in order, from plugging the adapter in to having
    a candump log worth decoding. Written from behaviour measured on saga today
    rather than from the man page, which is the whole reason it is worth having:
    the two traps below are not discoverable from documentation and either one
    silently ruins a capture.
    TRAP 1 -- SOCKETCAN CTRLMODE FLAGS PERSIST ACROSS BRING-UPS. After any loopback
    session, bringing the interface up with only 'listen-only on' leaves loopback
    set, and ip -details reports <LOOPBACK,LISTEN-ONLY>. At the tractor that
    captures our own echo and possibly nothing from the bus, and the log lo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
2026-09-20 PLC #4: two-node bench sketch -- R4 against a foreign node over a real bus
    What #19 did not prove. The loopback proof showed the controller receives a
    frame it transmitted itself, through the pads, over a wire. It said nothing
    about a transceiver, a differential bus, or a frame originated by somebody
    else. This pairs the Arduino against the RH-02 and tests both directions
    separately.
    THE RECEIVE DIRECTION IS THE ONE THAT MATTERS. The tractor is a bus full of
    foreign talkers and we are a listener. Transmitting is the bonus.
    TX prints a per-frame result with the write() return code, because a negative
    rc with a quiet bus almost always means the far end is not acking rather than
    that the R4 c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
2026-09-20 PLC #4: the display stops repainting itself, and `w` stops lying while frozen
    Two burndown fixes, #17 and #5. Alex authorised the burndown on 2026-09-20.
    #17 -- lcdLine() now skips the write when the row already says what it is
    about to be told. Every caller renders unconditionally on every loop pass, so
    the panel was being rewritten eighty characters at a time forever, each
    character two I2C pulses on the same bus the ADC is read over. The sample rate
    paid for that.
    THE CHECK IS INSIDE lcdLine(), NOT AT THE CALL SITES, AND THAT IS THE WHOLE
    POINT. The defect being replaced was a `lcdDirty` flag every caller was meant
    to set and none did -- written, never read. A cache in the one function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
2026-09-20 PLC #4: the R4 exchanges frames with a foreign node over a real bus
    PASS both directions, zero frame loss to about 1000 frames/s. This is the claim
    #19 could not make: loopback showed the controller hearing itself through the
    pads, this shows the R4 exchanging frames with an INDEPENDENT node across a
    TRANSCEIVER and a real DIFFERENTIAL bus, which is what the tractor is.
    Rig: UNO R4 Minima + Waveshare SN65HVD230 (powered from 3V3) against a Jhoinrch
    RH-02 on SocketCAN can0, 250k, RH-02 in normal mode. NOT issue #21 -- that is
    the WiFi board on D10/D13 and still waits for it.
    THE DIRECTION THAT MATTERS: frames originated by the RH-02 arrived at the R4
    intact -- 29-bit id, dlc and all eight p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
2026-09-20 PLC #4: cite the datasheets for the 3.3 V / 5 V warning instead of asserting it
    Alex pushed back on the transceiver warning being stated from recollection and
    asked for sources. He was right to. Both claims check out, and both are now
    quoted with their section numbers rather than left as my say-so.
    TI SN65HVD230 (SLLS555) section 8.1, Absolute Maximum Ratings:
    Digital Input and Output voltage, VI (D or R): -0.5 to VCC + 0.5 V
    Section 8.3 gives VCC as 3.0 to 3.6 V, so the ceiling at 3.3 V is 3.8 V. The
    Minima drives D at 5 V, over the ABSOLUTE MAXIMUM by about 1.2 V -- a damage
    limit, not a performance limit.
    Renesas RA4M1 datasheet, Table 2.4 I/O VIH VIL:
    Other peripheral input pins ex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
2026-09-20 PLC #4: plan the CAN logic-level interface, with datasheet citations
    The UNO R4 is fixed at 5 V logic and the SN65HVD230 on hand is a 3.3 V part.
    The pairing is out of specification in both directions. This scopes the fix:
    options, evidence, a recommendation and a bill of materials. No firmware
    change, no part ordered.
    Every electrical figure carries its part, document number and section, quoted
    from a datasheet downloaded while writing. Figures that could not be found are
    marked as such rather than estimated.
    Recommends a plain TJA1051T. It is the only candidate examined that closes both
    directions on guaranteed worst-case numbers: TXD VIH min 0.7*VIO = 3.5 V accepts
    the R4's 5 V drive, a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
2026-09-20 PLC #4: correct three transceiver claims, and record the decision to run unprotected
    A worker planning the overdrive fix checked my citations against the primary
    sources and found three errors in what I had already landed on main. Correcting
    them here. The worker's full analysis is on feat/plc4-can-level-interface-plan.
    1. THE REPLACEMENT PARTS I NAMED WERE WRONG. This file said to use a TJA1050 or
    MCP2551 and that it 'needs no argument'. Wrong on the receive direction and
    overconfident. Both publish their high-level output only at 0.7 x VCC = 3.5 V,
    UNDER the RA4M1's 4.0 V threshold: MCP2551 gives VOH min 0.7 VDD at IOH = 8 mA,
    and TJA1050 publishes no VOH minimum at all, only IOH -2 mA at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
2026-09-20 PLC #4: the 500 ms loop loses two thirds of the bus, measured
    Soak testing on the desk rig, with loss detected by SEQUENCE GAPS rather than by
    comparing totals -- cangen randomises payloads and cannot support that, so
    tools/can_soak_send.py sends a 32-bit counter and sketches/can_soak detects a
    dropped frame by its absence.
    REPORT.md 4.3 IS ANSWERED AND IT IS WORSE THAN FEARED. All runs at 200 frames/s:
    loop delay sent received lost loss ring high-water
    0 ms 11996 11996 0 0 ppm 1
    5 ms 6000 6000 0 0 ppm 2
    150 ms 4000 4000 0 0 ppm 30
    500 ms 5998 1938 4009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
2026-09-20 PLC #4: state the loss denominator, and where the missing 51 frames went
    The coordinator checked the 500 ms row by subtraction and it did not close:
    5998 sent minus 1938 received is 4060, but the lost column read 4009. Fifty-one
    frames unaccounted, in a piece of work whose whole argument is exactness.
    Neither number was wrong. The denominator was unstated and the gap method has a
    limit that was not written down.
    THE DENOMINATOR is lost/(received+lost) -- loss within the sequence span the
    receiver actually observed. 4009/5947 = 67.41%.
    THE 51 RECONCILE EXACTLY. The receiver saw 1938 frames and detected 4009 missing
    between them, so it observed sequence 0 through 5946. The sender sent throu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
2026-09-20 PLC #4: tell the census to RECORD the frame rate, not just produce it
    The procedure said to capture for at least a minute at each bit rate, which
    produces data containing the frame rate but never tells anyone to write the rate
    down as a result. Easy to skip precisely because the log contains it, so it feels
    captured -- and it cannot be recovered afterwards without going back to the
    tractor.
    It matters because the firmware's loop budget is driven by RATE, not by which
    PGNs exist:
    maximum tolerable loop period = ring depth / frame rate = 32 / fps
    A census listing the PGNs without the rate answers half the question and leaves
    #24 unable to choose between draining more often, filtering hard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
2026-09-20 PLC #4: four times today a verified fact carried an unverified inference
    Written at Alex's direction. Four instances in one afternoon between this
    coordinator and the estate consumer coordinator -- three ours, one theirs --
    where a fact that was true was used to support a conclusion it did not support.
    The pattern matters more than any of the four, because it is the failure that
    SURVIVES CHECKING: checking the fact passes, and the error sits one level up in
    the step from the fact to what it is taken to mean. The clearest was "reset and
    uptime_s arrive in the same frame as the counter", which is accurate about the
    status frame and was inferred onto telemetry, which carries neither field.
    Th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
2026-09-20 PLC #4: the note's open question is answered, so it stops saying NOT DETERMINED
    The consumer coordinator ran the seven-dashboard check rather than leaving it
    open. No Grafana panel presents an interruption statistic as a health signal.
    Every lag() in the provisioned dashboards is a rate delta, a reboot-transition
    detector, an episode boundary, or the one real instance already filed as issue
    #27 on that repo.
    Recorded on their measurement and attributed as such -- the dashboards live in
    /opt/plc1-monitoring, which this repo does not own and did not inspect.
    A section headed NOT DETERMINED that HAS been determined is exactly the stale
    document this estate keeps paying for, so it is replaced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
2026-09-22 PLC #4: fold the J1939 CAN reader into the scale firmware (#24)
    Alex, 2026-09-22: the CAN and scale firmware merge and go onto the board
    tethered to tatonka. One image, one MQTT client, one will.
    - include/j1939_decode.h: the can_mqtt decoder, made pure (no Arduino) so the
    host can run it. TP.CM/TP.DT not addressed to global are now ignored: the
    census shows SA 0x00 running RTS/CTS to SA 0x06 while broadcasting BAM, and
    its TP.DT would have corrupted an open BAM.
    - include/j1939_can.h: drain + decode in a 200 Hz FspTimer ISR, so frames keep
    arriving through WiFi.begin() and PUBACK spins. loop() reads via snapshots
    taken under noInterrupts(). Never transmits.
    - Hardware acceptance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
2026-09-22 PLC #4: publish the CAN drain count, so frames 0 can be diagnosed over MQTT
    On the tractor 19f0c022 published frames 0, ring_high 0, can_err 0 for 75 s
    with the key being switched on. Over MQTT that cannot tell a drain that
    never runs from a bus that never reaches the pin. `drains` (ISR executions)
    and `can_last` (the last driver error code) separate them without a console.
    Claude-Session: https://claude.ai/code/session_0124B9NViL1H4TfaacN8vaP9
2026-09-22 PLC #4: fix engine values vanishing -- signed signal age, hours window 30 s
    First field run of 19f0c022 on the 5055E (2026-09-22): CAN received fine,
    but rpm was missing while the engine ran, load/torque appeared once, and
    hours never appeared.
    Cause: the decoder stamps signals in the timer ISR, so a value can be newer
    than the loop's `currentMillis`. Unsigned `now - ts` then wraps to ~49 days
    and reads stale. EEC1/EEC2 at ~50 Hz are almost always newer than the loop's
    clock. Fixed with a signed age, and publishEngine() now reads millis() after
    its snapshot.
    Hours: the census shows PGN 65253 every ~4.8 s, on the edge of the 5 s
    window; it gets a 30 s window of its own.
    dtc/0 absent is cor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
2026-09-22 PLC #4: engine dashboard and consumer proposal rebuilt for the real payload
    Three independent designs, a judge, a builder and a validator (a throwaway
    PG16 with the migration applied; every panel query run on realistic rows,
    including the 19f0c022 payload shape).
    - Dashboard: an operator band that keeps NO DATA, "not reported" and a real
    0 apart; a state timeline; value trends; signal coverage (the acceptance
    check after the next flash); CAN health and filter-trial rows; per-ECU
    lamps (SA 3/6/23/71) and active DTCs, with DTC age labelled "since last
    publish", not ECU liveness.
    - 067 proposal: CAN health columns (ring_full, ring_high, can_err, can_last,
    drains, can_up, filt), board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
2026-09-22 PLC #4: fuel level, hydraulic oil temp, and min/max/avg of rpm/load/torque
    Alex, 2026-09-22 ("Top picks only") from the signal survey of the census:
    - fuel_level_pct: SPN 96, DD PGN 65276 byte 2, 0.4 %/bit, from SA 0x17.
    SA 0x47 also sends DD with every byte 0xFF; the sentinel check skips it.
    - hyd_oil_c: SPN 1638, VF PGN 65128 byte 1, 1 degC/bit, -40, from SA 0x47.
    - rpm/load_pct/torque_pct _min/_max/_avg over each 15 s engine window, from
    every valid ~50 Hz sample the ISR decodes; omitted when the window saw no
    valid sample. The window is taken and reset every ENGINE_MS even while
    offline, so a published window never spans an outage.
    - Filter mask widened to 16-PGN blocks (0x03FFF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
2026-09-25 PLC #4: keep the power-up EEC1 placeholder out of torque (#57)
    On the tractor (699e3c6c) the first key-on window stored
    torque_pct_min = -125. Cause, from census candump-2026-09-22_175648.log:
    the 5055E's first EEC1 after power-up is F0 FF 00 00 00 FF FF FF (torque
    byte 0x00 = -125 %, rpm 0); every later frame carries 0x7D (0 %).
    A raw 0 torque byte is now kept only when the same frame shows rpm > 0,
    where -125 % (motoring) can be real. At 0 rpm it is dropped from both the
    latest value and the min/max/avg window.
    Tests: the new replay checks fail against main's header (torque window min
    -125 on _175648) and pass with the guard on all four census logs (21/21).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
2026-09-25 PLC #4: correct the hours and DM1-cadence claims (#52)
    Engine hours were written up as "broadcast unprompted" because PGN 65253
    appears in 39 of 44 Cal Poly captures. Presence is not cause: the corpus has
    291 hours frames and exactly 291 requests for 65253 (SA 6 to global, SA 23
    to the engine), and our 2026-09-22 census shows a request ~5 ms before every
    18FEE500. The conclusion for #23 stands (nothing is transmitted; other ECUs
    ask), but freshness depends on them.
    DM1 is not 1 Hz on this model: ~2 per ECU per capture, ~5 s apart, in the
    corpus; ~2 per ECU around key-on/start, and none at key-on idle, in the census.
    REPORT.md (§3 summary, §6 table and prose, §8 item 4), the corpus findi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
2026-09-28 Check card 00 against build 699e3c6c and restamp it
    Add the J1939 engine data and fault codes the build publishes, replace the
    unverified lift-circuit and suspended-load claims with what the records
    support, and stamp the card with the build it was checked against.
2026-09-28 Check card 01 against build 699e3c6c, add the CAN pins and restamp it
    Replace the partial pin note with the header pins the build uses, including
    CAN on D10 and D13 from the UNOWIFIR4 variant, name each bus device from the
    firmware headers, add the display rows, and stamp the checked build.
2026-09-28 Check card 02 against build 699e3c6c and restamp it
    Remove the shield-grounding row and the supply-isolation reasoning, which no
    design record in the repo supports, state the compliance margin from the
    MCP3421 design record, and stamp the checked build.
2026-09-28 Check card 04's rulings against the repo records and restamp it
    Keep "Alex" only where a record attributes the ruling to him, mark the rest
    derived, drop the rows no record attributes and that restate firmware
    behaviour, and add the rulings the records hold: topic root, RAM-only queue,
    QoS 0 ack, the operator interface, listen-only on the tractor bus,
    single-point calibration, tare before each session and the frozen filter.
2026-09-28 Check card 07 against build 699e3c6c, add can and canf, restamp it
    Add the console verbs can and canf and the argument ranges the build
    enforces. Name the display messages as the build writes them (NO ADC, not
    "no converter"), state when CAL NOT SET! clears, give the refusal reasons the
    build carries, and remove the reset-button advice no record supports.
2026-09-28 State the wiring conventions once, in card 00
    Add 00 Wiring conventions: crossed transmit and receive, one multiplexer
    channel per bus device, and a common ground for every supply that feeds a
    signal the board reads. Strip the per-termination reasons those conventions
    now cover from card 01 (the crossed radio pair, the channel-select note) and
    card 02 (the ground-bond reason).
2026-09-28 Clear history, status and non-standard front-matter from the cards
    Every card's front-matter is now the H1, Document and Firmware lines only;
    the card-type heading, the letterhead line and the Controller line go.
    Remove history from 00 (dated records), 02 (earlier card, metered on this
    estate) and 04 (the burden's past values, the repository-history note), and
    turn the old burden values into a forward instruction in 02. Drop 04's
    commissioning row. Give 05's closed defects present-tense titles. 00 cites
    07 for the boom procedure instead of restating it. Also correct 02's
    unverified "lift circuit" to the loader hydraulic circuit.
2026-09-28 Record issue 57 in card 05 as a defect of build 699e3c6c
    In the build's EEC1 decode a torque byte of 0 enters torque_pct and the
    torque window as -125 % with no engine-speed condition, so a frame sent at
    0 rpm reads -125. Evidence is the 699e3c6 source only.
2026-10-03 docs: move JD 520M spec sheet to docs/vendor/john-deere/
    Alex ruled 2026-10-03: all vendor files and datasheets go in docs/vendor/<maker>/.
    Update the one path reference in notes/2026-09-13-4-20ma-loop-decisions.md.
2026-10-03 docs: file vendor datasheets for every identified PLC #4 device
    Alex ruled 2026-10-03 that every vendor file and datasheet goes in
    docs/vendor/<maker>/, and asked for the missing datasheets to be fetched.
    22 PDFs from manufacturer sites (Arduino, Renesas, TI, Microchip, Nuvoton,
    Diodes, Waveshare, Emerson, John Deere), plus one Farnell mirror for the
    TJA1051 because nxp.com refuses requests from Saga. Each was checked with
    pdftotext for its part number before staging.
    docs/vendor/MANIFEST.md records device, file:line citation, source URL,
    SHA-256 and fetch date for each, including the existing 520M sheet (source
    NOT DETERMINABLE: Alex supplied it, commit 34d0a25). It also lists what could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
2026-10-07 references: drop printed_date from the binder manifest (#67)
    RULES.md rule 58 forbids printed_date; the renderer's page stamp
    carries currency. One line removed, nothing else.
2026-10-07 findings: proposal for can_err missing multi-flag CAN events (#53)
    PROPOSAL ONLY. No firmware or library change.
    The FSP error ISR passes EIFR (plus MAILBOX_MESSAGE_LOST when STR.NMLST)
    as the event word, so it can carry several flags. Arduino_CAN's exact-value
    switch reports 5 of the 248 words that ISR can deliver. Proposes a repo copy
    of Arduino_CAN with one default: arm, built via --library.
    Adds a host test, marked PROPOSED, proving the classification over every
    reachable error-ISR word and all 16-bit words.
    Refs #53
    Claude-Session: https://claude.ai/code/session_01EKVHDzLPzuXfNQ3GwkJWEp
2026-10-07 findings: #53 proposal revised after review, recommend repo-side hook
    PROPOSAL ONLY. No firmware file includes the new header yet.
    The adversarial review showed a repo-only route: find the CAN0 error
    ICU slot, take the control block IRQManager stores as its ISR context,
    and R_CAN_CallbackSet a hook that records any error word and forwards
    to CAN.onCanCallback. Anchors verified against 1.6.0; the integrated
    version compiles warning-free at +200 B flash, +8 B RAM. It re-installs
    after every CAN.begin(), since R_CAN_Open resets the callback.
    Recommends it over the lib/ fork, which only took effect with --library
    and so was not covered by direct arduino-cli builds. Adds
    include/can_event_mask.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
2026-10-07 can: count multi-flag driver error events in can_err (#53)
    Approved by Alex for build only, 2026-10-07. Not flashed.
    The FSP error ISR passes EIFR (plus MAILBOX_MESSAGE_LOST on STR.NMLST)
    as the event word, and Arduino_CAN's exact-value switch drops any word
    with more than one flag. j1939_can.h now installs a callback hook on the
    CAN0 error slot's control block: it records any error word, then
    forwards every event to CAN.onCanCallback unchanged. canOpen()
    re-installs it after every CAN.begin(), including the canf reopen,
    since R_CAN_Open resets the callback. The drain merges the hook's word
    with the library's flag; with no hook, behaviour is as before. The
    console `can` verb shows whether t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
2026-10-07 CLAUDE.md: stop naming farm1 as the board's USB host
    Measured 2026-10-07: farm1's only serial device is a Seeed TRACKER L1, so the
    line sent sessions to a host that does not have the board. Name the check
    instead (/dev/serial/by-id on the host) rather than a location that changes.
    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
2026-10-07 notes: RFID one-step record flow, phone GPS/time, board publishes
2026-10-07 notes: RFID reader on D0/D1, UART bridge dropped
2026-10-07 findings: RFID tally hardware recommendation
    Platform comparison (UNO R4 WiFi, Opta WiFi, Portenta Machine Control,
    Waveshare ESP32-S3), reader, antenna, tags, power, enclosure and BOM,
    each cited to a datasheet or file:line. Recommends staying on the
    UNO R4 WiFi with an M7E Hecto behind a 5 V/3.3 V level interface.
    Files the SparkFun M7E Hecto schematic (CC BY-SA 4.0) under
    docs/vendor/sparkfun/ and records it in the vendor manifest.
2026-10-07 findings: revise RFID hardware recommendation after review
    Records Alex's ruling (new UNO R4 WiFi plus protection and a
    screw-terminal shield; range-only records). Corrects the M7E power
    figure to 3.1 W at +27 dBm (0.665 W is Ready). States the RAM limit:
    a 200-entry RFID event queue is 30.4 KB against 14,976 B free. Picks
    the Adafruit Proto-ScrewShield R3 with the D-1683 as alternative, adds
    both to the BOM, and lists the cranking, load-dump, tag-on-bag and
    tag-price open items.
2026-10-07 RFID contract: consumer-confirmed delivery, QoS 0 kept, hand-off status
    Applies Alex's 2026-10-07 rulings: "Consumer confirms, app resends" and
    "Approve and hand off". src/ untouched; board firmware still gated.
    - Withdraw board-side QoS 1, the PUBACK-gated dequeue and the 5 s retry.
    The weight topic stays QoS 0 (src:407); backlog means what it does today.
    Keep the single FIFO, depth 16, QUEUE FULL refusal and the mustQueue
    ordering rule.
    - Specify the confirmation leg for the consumer coordinator on
    plc4/jd5055e/confirm: confirm by rec / tally, app resends unconfirmed
    voids and tally ends under a NEW command id after 10 s, records are
    flagged unconfirmed and never resent.
    - Fix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
2026-10-07 RFID contract: consumer review fixes (C1-C4, C7, C9, C10, R1)
    Tally IDs are app-generated UUIDs, a hard requirement; a UUID fits the
    40-char cap. Voids carry tally in the command and the event. The consumer
    model keeps, flags and confirms an orphan void, keeps the first of a
    redelivered record, and flags late arrivals after tally_end. The note names
    the QoS 1 redelivery path for a repeated rec, states the phone-time rule,
    the QoS 0 consumer-restart loss, the relayed consumer-side tally rulings,
    and lists app-side items for the PWA owner. The findings note gains the
    bench-identity item.
2026-10-14 RFID: record Alex's ruled build; apply review corrections
    Alex chose "Cheap tags, no antenna" (coordinator's option text): the
    M7E on its on-board antenna, 200 RSCT-U8-AN-10330 cable-tie tags,
    $646.35 priced. The 10-07 recommendation gains a current-build section
    and dated Superseded markers on the antenna, coax, bulkhead and Sentry
    Duo lines; the old text stays in place. The 10-14 COTS finding
    withdraws "no tag beats $1.86", restates EPC uniqueness as a one-time
    write requirement, and adds the SR691 listing's missing RS-232.
2026-10-14 Opta WiFi platform evaluation: keep the UNO-only build
    Evaluates moving PLC #4 to an Arduino Opta WiFi with the UNO kept as a
    CAN node, per Alex's 2026-10-14 request. Tests the 10-07 rejection
    against the datasheets: no CAN is confirmed; the expansion port is I2C
    on the wire but unpublished; the loop can be read via the A0602 Analog
    Expansion. Covers the split architecture, the Portenta Machine Control
    as the one-box alternative, cost and enclosure.
    Files the Opta, A0602, digital expansion, Portenta Machine Control and
    Mean Well DDR-30 datasheets under docs/vendor and adds them to the
    manifest.
    Claude-Session: https://claude.ai/code/s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
2026-10-14 Opta evaluation: apply adversarial review fixes
    Corrects the queue-depth and PG9/PG14 citations, and supports the
    12-byte record size from the 10-07 finding. Adds the Opta's +50 C
    ceiling as the likelier thermal risk, and the DEVICE_CAN=1-but-no-pins
    note. Gives the strongest form of the split (UNO on CAN only, Opta
    weighing with the reader) its own option in the decision section. The
    recommendation holds. Updates the manifest's shifted line references.
    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
2026-10-25 Binder: fix the #68 audit findings in references/
    Groups 1-15 of issue #68 against uno_r4_wifi build 699e3c6c:
    - Stamp names the variant; no build id or closed tracker in card 05 prose.
    - Card 02: 12 V dc minimum cited to the Rosemount PDS; terminal table and a
    circuitikz schematic replace the ASCII drawing; 29.7 mA removed.
    - Card 03: ack-id exception, dtc keys spn/fmi/oc, partial-payload no-ack,
    counters "since the last reset"; PGN/SPN cited to j1939_decode.h.
    - Card 06: w0 reverts to 0.1, row-3 order cited to 01D, counters since reset.
    - Card 01 split into the board plus 01A radio module, 01B SN65HVD230 CAN
    board, 01C Qwiic stack, 01D display; normal CAN mode; J1939-11 claim gone.
    -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
2026-10-25 Binder: #68 re-audit rework
    - G8: card 04 cites the Rosemount PDS for NE43; loop_scaling.h only for 3.5 mA.
    - G10: each board pin in one row (D0/D1 in 01A, D10/D13/GND in 01); blank
    Wire column on 01C and 01D; 01A keeps only board-side pins and baud.
    - G12/G13: card 03 cites 02 for the dead-loop cause; argument passages cut
    to one-line statements.
    - 01 names ABX00087 as a datasheet; 01B states R2 120 ohm from the schematic.
    - Rule 95: canf standing hazard, the sm range guidance and the tare constant
    offset restored as plain statements; 22.64 V and 2 s replace the hedges.
    - Card 00 wiring conventions: "Fault when broken" replaces the Why column.
    - Rule 71: docs/vendor/MANIFEST.md and BR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
2026-10-25 notes: record the PLC #4 RFID case print artifact and its V1/V2 state
2026-10-25 notes: case generator found in greybeard-plc4-pwa design/case-print
2026-10-25 notes: RFID read range, V1 case reader orientation, external antenna option
2026-10-25 RFID: record Alex's 2026-10-25 external-antenna ruling; banner the 10-07 and 10-14 findings
2026-10-25 notes: RFID antenna comparison and reader-to-antenna feed parts, reviewed
2026-10-25 notes: record Alex's antenna choice, Vulcan C610
2026-10-25 notes: C610 mounting options for the fork carry, recommend the quick-attach frame
2026-10-25 notes: RF exposure distance per the JADAK guide (20 cm)
2026-10-25 notes: start the PLC #4 case V2 inputs log
2026-10-25 notes: case V2 log, antenna placement and Alex's open handheld-reader question
2026-10-25 findings: where the RFID read happens, four routes, reviewed
    Alex's open question from notes/2026-10-25-rfid-read-range-and-antennas.md §6.
    Options only; nothing decided.
2026-10-25 notes: case V2 log, entry 6 answered (reader off PLC #4, pendant)
2026-10-25 spike: fold the review into the C3 header plan (V3V, 2.0 mm pitch, no CDC, one-shot 0x05, restore at 0x0)
2026-10-25 spike: PN532 over I2C, probing the Grove pins both ways and the board bus (Alex: plug labelled SDA/SCL)
2026-10-25 spike: back to PN532 over UART on the Grove plug (Alex: SDA/SCL labels were the PN532 header's front)
2026-10-29 design: on-board PN532 reader, four sealed buttons and LCD menus for PLC #4
    Alex, 2026-10-29: put the T-Deck pendant's RFID chip on the tractor,
    with the buttons and menus an operator needs to scan a tag. Design only,
    no firmware change; FW-1..FW-8 are separate gates for his approval.
    - Reader: Elechouse PN532 V3 in I2C on the header Wire bus (A4/A5, 0x24),
    off the Qwiic measurement trunk; HC-05, CAN and Qwiic unchanged.
    - Buttons: four SparkFun COM-11966 (IP65) on D2-D5, 200 Hz timer debounce.
    - Menus: 22 screens at 20x4; row 0 weight and row 3 fault row kept.
    - Data path: the board POSTs the pendant's own /api/cmd RECORD, so the
    tag pin, the dup warning and the bag reading see it; no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
2026-10-29 design: one modem call per loop pass, UHF stated, scope split (a)/(b)
    Review findings from the PLC #4 coordinator, fixed:
    1. HTTP is a state machine: one WiFiClient call per loop() pass, last in
    the pass, only online and under 5000 ms in. Worst case per pass 25000
    ms on OPEN (two modem commands at MODEM_TIMEOUT 10000), 15000 ms
    otherwise, against the 30000 ms heartbeat. The "watchdog covers a
    hung call" line is gone.
    2. Near the top: the PN532 reads only 13.56 MHz NFC; the UHF EPC Gen2 bag
    tags read as nothing.
    3. HOME's OK points at MENU's section.
    4. RFID-build panel: the tag check is skipped and the tag goes to
    rfid_command as an EPC (app.py:350-351); an 8-hex UID passe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
2026-10-29 design: record Alex's choices (PN532, full pendant set); 2000 ms stage gate
    Alex chose, in the PLC #4 coordinator's dialog (option labels, relayed):
    "PN532, as you said" with the UHF consequence stated, and "Full pendant
    set" for the menus.
    - Record both in §1 as his choices; note the PN532 was chosen with the
    UHF paragraph in view.
    - Part (b) is in scope: drop the "scope choice" label; (a)/(b) is now the
    build order. Four buttons fitted from the start; FW table, §3.1, §3.4,
    §5.6 and §10 follow.
    - Panel stage gate tightened from 5000 to 2000 ms: worst case per pass
    under 22000 ms on OPEN (margin 8000 ms) and under 12000 ms otherwise
    (margin 18000 ms) against the 30000 ms hear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
2026-10-29 feat(plc4): on-board NFC, buttons, menus and panel client as pure logic, with host tests
    FW-1 to FW-8 of docs/design/2026-10-29-onboard-rfid-buttons-menus.md, the
    parts that carry no Arduino dependency, so each can be run on the host:
    - include/pn532.h: PN532 frames, ACK and response parse, the tag's wire form
    (greybeard-plc4-pwa api/commands.py:306-313) and screen forms, the kGoneMs
    scan rule, and a step driver making one I2C transaction per step. Written
    fresh from NXP UM0701-02, not from the GPL-3.0 mesh driver.
    - include/hmi_buttons.h: 4-sample debounce, 4-deep press queue, UP/DOWN
    repeat at 500/150 ms, KEY STUCK at 10 s.
    - include/cmd_id.h: p4-<session>-<n>, session taken lazil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
2026-10-29 feat(plc4): wire the NFC reader, lid buttons, menus and panel client into the firmware
    FW-1 to FW-8 of docs/design/2026-10-29-onboard-rfid-buttons-menus.md, on the
    pure logic of the previous commit:
    - FW-1: PN532 on Wire (A4/A5) at 0x24, one I2C transaction per loop pass,
    new scans by the kGoneMs rule, handed to the menu.
    - FW-2: BACK UP DOWN OK on D2-D5, sampled by a third FspTimer at 200 Hz
    (allocated after the heartbeat and CAN timers; loop fallback), KEY STUCK
    on the fault row above I2C ERR.
    - FW-3: row 0 the weight row on every screen and row 3 the fault row, as
    today; rows 1-2 belong to the screen; HOME draws today's rows unchanged.
    PLC4_HMI_FULL selects part (a) or (b) at b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
2026-10-29 fix(plc4): show a delivery's customer on the 20-column rows, not the panel's long label
    The panel labels an open delivery "DELIVERY <picking_name> <customer_name>"
    (greybeard-plc4-pwa df172d2 api/simple_tally.py:162-169). Cut to the 13 or 11
    columns TAG and TALLIES give it, every delivery read "DELIVERY WH/O". Open
    tallies carry their delivery fields (rfid.py:169-171 DELIVERY_FIELDS), so the
    scan takes customer_name where there is one, else the label without its
    leading "DELIVERY ". That is the design's "SMITH #4411" intent (§4.6, §4.9).
2026-10-29 fix(plc4): never record a tag twice after a lost answer; TARE only locally if unsent; verbs read state first
    Review BLOCKING-1. The cmd's SEND went out, the READ missed the 8 s deadline,
    the screen showed NO PANEL, and the board's verdict for the "+" was dropped
    because it settled only on PH_VERDICT+BUSY or NO ANSWER. The tag stayed
    armed, so BACK -> TAG -> OK minted p4-00000001-2 and recorded the same tag
    again. Fixed:
    - PanelHttp::wrote() reports whether SEND ran (set before the write, since a
    part-failed write may still have gone out). onPanelResult() takes it.
    - A cmd that fails after SEND is NO ANSWER: OK resends under the SAME id and
    a late verdict settles it. A deadline before SE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
2026-10-29 fix(plc4): Wire after the watchdog's timer, allocation failures reported, status never truncated, one URL
    Review items 4, 5 and 6.
    - Item 4: Wire.begin() moves out of the boot i2cScan() to after the heartbeat
    and CAN timers, so an interrupt-slot shortage can never cost the watchdog
    its timer; the button timer follows it. The R4 keeps TwoWire::init_ok
    private and a failed init makes every address "answer" (Wire.cpp:497-530),
    so wireLooksInitialised() treats 0x08 and 0x77 both acking as a failed
    controller (inference from the core's source) and the reader stays off.
    Boot prints each allocation; status carries `hw_fail` (hb_timer,
    can_timer, btn_timer, wire) only when something f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
